ok1hra/IP-rotator/README.md

# IP-rotator firmware

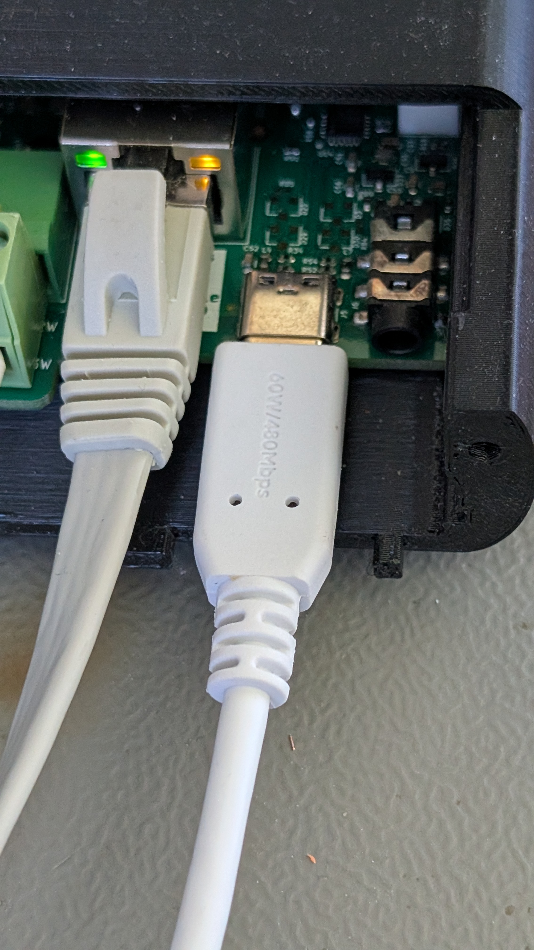
[picture p1: img/wiki-simple-rot-plug-usb-c.jpg]
https://raw.githubusercontent.com/ok1hra/IP-rotator/main/img/wiki-simple-rot-plug-usb-c.jpg


- First plug USB-C between rotator and PC
- Then open the Firmware page and follow the instructions [https://ok1hra.github.io/IP-rotator/](https://ok1hra.github.io/IP-rotator/)
- Manual available on the [Wiki page](https://remoteqth.com/w/doku.php?id=simple_rotator_interface_v) | [copy on GitHub](Assembly-manual.md)
