ok1hra/IP-rotator/control-zoom0.png

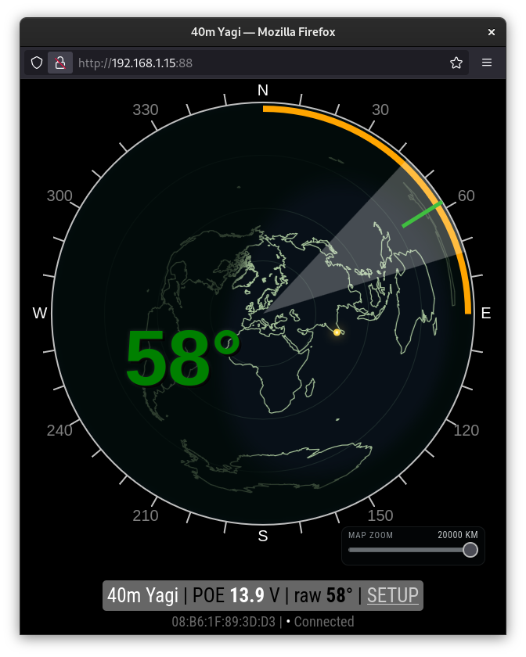
control-zoom0.png
