ok1hra/IP-rotator/control-zoom1.png

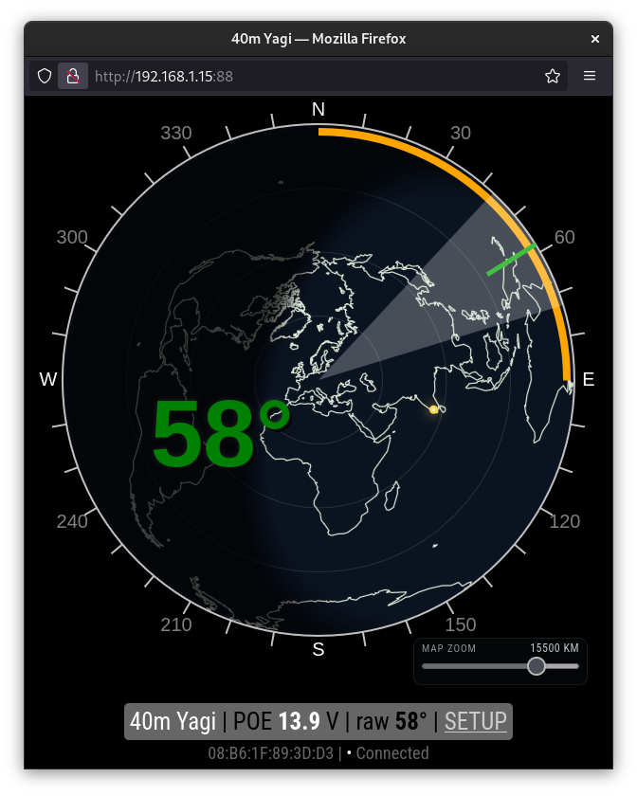
control-zoom1.png
