ok1hra/IP-rotator/control-zoom2.png

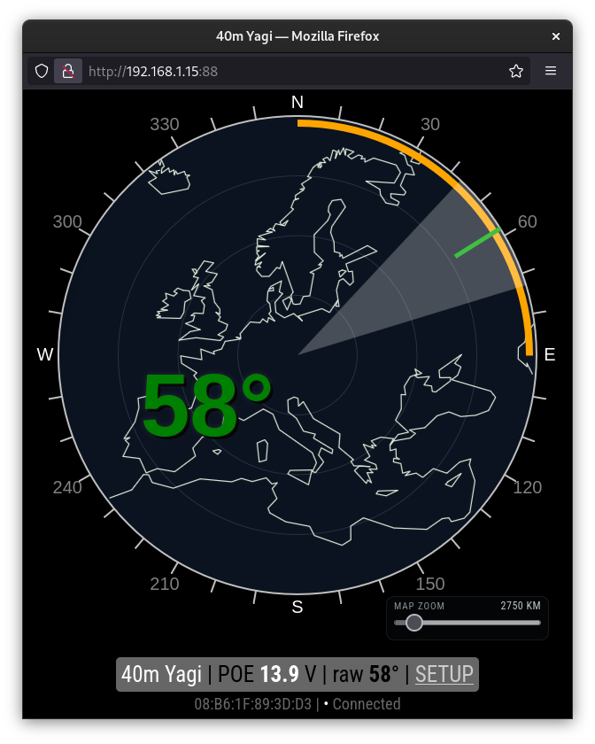
control-zoom2.png
