ok1hra/IP-rotator/elevation.png

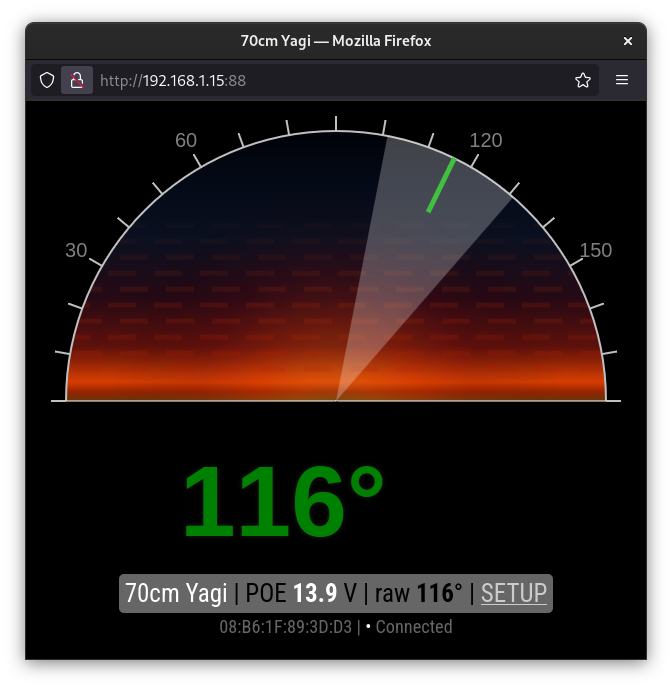
elevation.png
