ok1hra/IP-rotator/img/wiki-simple-rot-62.png

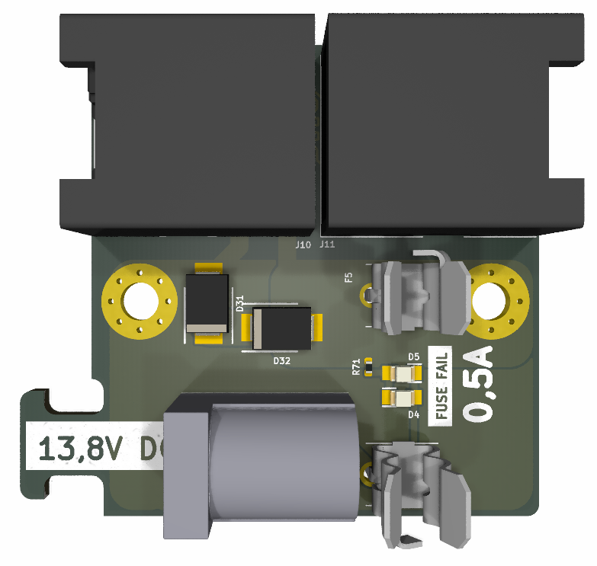
img/wiki-simple-rot-62.png
