ok1hra/IP-rotator/img/wiki-simple-rot-70.jpg

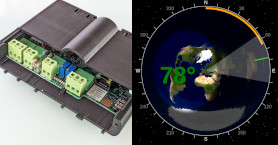
img/wiki-simple-rot-70.jpg
