ok1hra/IP-rotator/img/wiki-simple-rot-70b.jpg

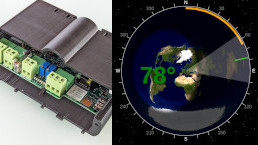
img/wiki-simple-rot-70b.jpg
