ok1hra/IP-rotator/img/wiki-simple-rot-render.png

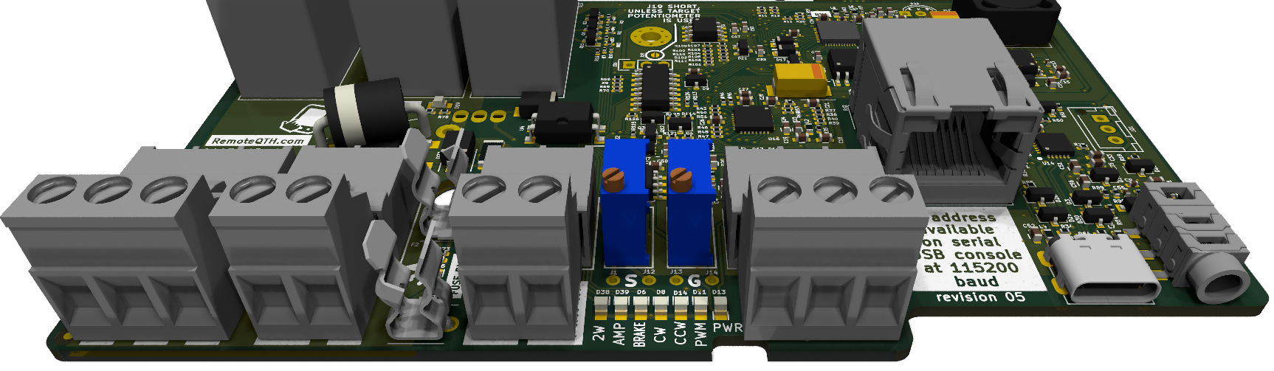
img/wiki-simple-rot-render.png
