ok1hra/IP-rotator/build/recovery-web/index.html

Two options - update or restore the entire device

# IP Rotator firmware

Firmware version: 20260912 for Hardware (https://remoteqth.com/w/doku.php?id=simple_rotator_interface_v)

## Update via the EasyOTA web service

Download the two .bin files and upload them on the device web update OTA page http://[ip]:82/update in this order: first firmware, then filesystem.

Files for EasyOTA update:

Firmware 20260912.bin SPIFFS 20260912.bin

## Complete recovery via USB

Use this path for device recovery. Open this page in Google Chrome or Microsoft Edge over https://, connect the IP Rotator to your computer using USB-C, then start the automated install below.

- Before recovery, back up your configuration from the Setup page http://[ip]:88/setup, Backup and restore part
- After pressing the Connect button, select the CP2104 USB to UART Bridge Controller device
- Then select the Install IP Rotator Recovery option
- After uploading, select the USB device again and the Logs & Console option, where after pressing Reset Device you will see the boot log, including the device's IP address

The installer flashes bootloader, partition table, boot_app0, firmware, and spiffs automatically.
