ok1hra/IP-rotator/setup.png

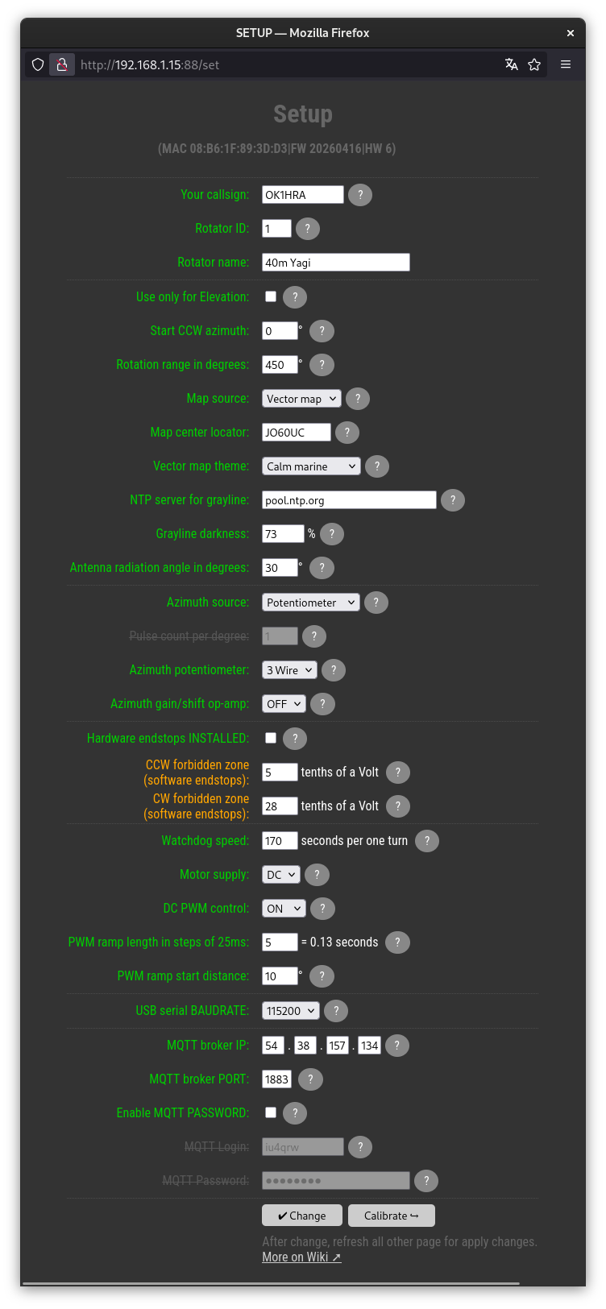
setup.png
