ok1hra/IP-rotator/calibrate.png

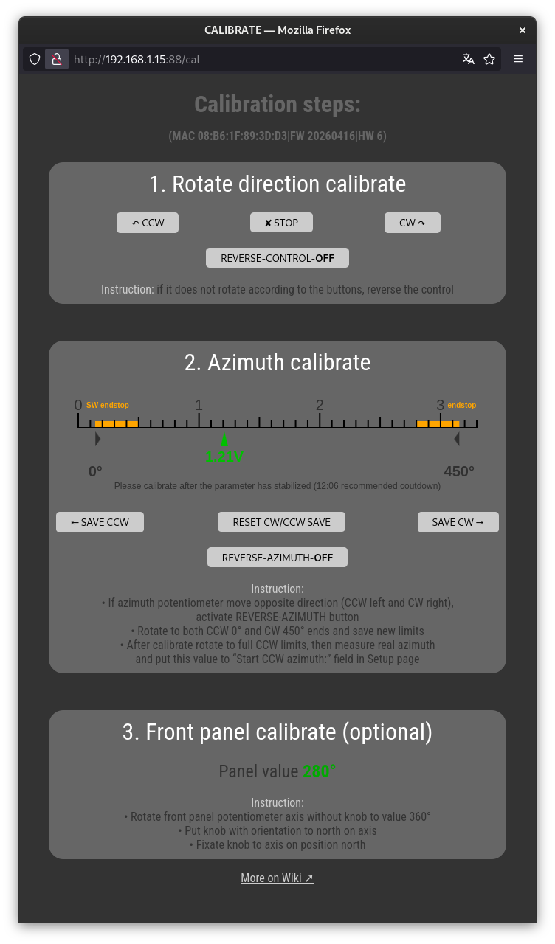
calibrate.png
