ok1hra/IP-rotator/(threads)

Thread 2 (2024-01-31):

Are you planning other positioning sensor in the future?

iu3qez, 2024-01-31:
Hi,

Happy user of the IP Interface. Really a great product.
Unfortunately my rotor had decided to give up: as usual the 500 ohm potentiometer is gone (I already tried to repair it.. But after a couple of weeks it broke again).

As this is a weak point of this kind of rotor (Hy Gain, CDE etc), I'm thinking to replace the 500 ohm potentiometer with some other positioning system...  Also their cost has gone crazy lately.

What I have in my mind are:
1) a simple magnetic encoder;
2) a magnetometer
3) some other kind of potentiometer based position.

I know that the hardware and software well support the 3), what about the other 2? Would be possible to implement without drastic change in the code?

73 de Simone IU3QEZ

ok1hra, 2024-02-04:
There are two options

1. use the analog input, i.e. if the sensor produces a voltage of 0-9V, you can connect it directly to the IP rotator
2. create an independent sensor that is connected to WiFi or Ethernet and sends location data via IP - it would require intervention in the code.

73, Dan OK1HRA

Closed 2024-04-29.

Thread 3 (2024-10-06):

PWM issue ?

jrueschenschmidt, 2024-10-06:
Hello Dan,

I think I found a bug in line 1889. I assume it should be -3.

1886   case -2: {
1887   	if(PWMenable==true){
1888    	    if(abs(AzimuthTarget-Azimuth)<10){
1889        	**Status=3**;
1890            }
1891        }else{
1892    	    if(abs(AzimuthTarget-Azimuth)<2){
1893		Status=-3;
1894	    }
1895       }

73 de Joerg (DL3QQ)

ok1hra, 2024-10-09:
Yes Joerg, it is bug.
Now fix in last release 20241009
TNX!

ok1hra, 2024-10-09:
close

Closed 2024-10-09.
