ok1hra/IP-rotator/IP-rotator.ino

/*

IP rotator firmware
----------------------
1. Increase REV value in this .ino
2. Arduino IDE 1.8.19 menu: Sketch/Export compiled Binary (for HARDWARE ESP32-POE + Tools/Partition Scheme:"Default")
3. optional if change: $ python3 tools/generate_map_dataset.py
4. generate all .bin and publish to GitHub web page: $ ./tools/all.sh --publish
5. git commit with comment Release number and push

For partial update witout release
1. Arduino IDE 1.8.19 menu: Sketch/Export compiled Binary (for HARDWARE ESP32-POE + Tools/Partition Scheme:"Default")
2. build SPIFFS.bin: $ tools/build_spiffs_image.sh
3. update va EasyOTA
4. git commit and push


 ___               _        ___ _____ _  _
| _ \___ _ __  ___| |_ ___ / _ \_   _| || |  __ ___ _ __
|   / -_) '  \/ _ \  _/ -_) (_) || | | __ |_/ _/ _ \ '  \
|_|_\___|_|_|_\___/\__\___|\__\_\|_| |_||_(_)__\___/_|_|_|

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
Used MQTT-WALL, credit Adam Hořčica, is under MIT license,
see https://github.com/bastlirna/mqtt-wall/blob/master/license.txt

Contributors: Joerg DL3QQ, Mark G4MEM

MQTT monitor
mosquitto_sub -v -h 192.168.1.200 -t 'OK1HRA/ROT/#'
mosquitto_sub -v -h 54.38.157.134 -t 'OK1HRA/1/ROT/#'

MQTT topic
mosquitto_pub -h 192.168.1.200 -t OK1HRA/0/ROT/Target -m '10'
mosquitto_pub -h 54.38.157.134 -t BD:2F/0/ROT/Target -m '10'
mosquitto_pub -h 54.38.157.134 -t 3D:D3/0/ROT/RxAzimuth -m '10'


Changelog:
+ rotator name
+ watchdog timer, azimuth change
+ stop zone gray color
+ under 11V POE voltage watchdog
+ azimuth target
+ rotator ID for more units mqtt identification
+ calibrate gui set
+ software endstop zone
+ darkzone map, if range < 360
+ watchdog speed limit in gui
+ HW detection show in GUI
+ web online status (timeout 2s)
+ on hover button
+ fix url button
+ diffrent low/high endstop zone
+ control key
+ AC functionality
+ AZ potentiometer
+ LED
+ Supported GS-232 commands: R L A S C Mxxx O F
+ CW/CCW pulse inputs gui
+ serial baudrate set
+ warm up timer for stable value
+ AZtwoWire L=three H=two wire AZ pot
+ AZpreamp L=preamp on H=pre amp off
+ if source AZsource == false && TwoWire == true && CwRaw < 1577 | then show recomended
+ add reverse azimuth button
+ click to map during rotate stoped
+ BRAKE in DC mode support
+ if mqtt_server_ip[0]=0 then disable MQTT
+ Disable PWM from setup gui
+ if PWM in gui OFF, AC-cw out for DC input, if PWM disable and high voltage
+ small stop ramp if(abs(AzimuthTarget-Azimuth)<2)
+ rename PWR to POE on main control page
+ reset button for calibrate settings in setup
+ calibrate control potentiometer on north (show ° in setup gui)
+ DC use brake relay
+ add AzimuthStop mqttpub
+ support HW rev 6 and 7
+ add new settings to setup gui for PWM
  - PWM ramp length
  - PWM start distance
+ add new azimuth source from MQTT with topic /RxAzimuth
+ add new parameter MQTT Login and Password
+ add support for Elevation only

ToDo
- test
  - if stop, after run over target
  + 10 turn pot without preamp
  + test preamp linearity
- save settings (dump eeprom?)
- show target from az pot in map
- disable target in map if status = 0 (not rotate)
- need implement
  - CW/CCW pulse functionality
  - CW/CCW pulse pulse per grad
  - serial protocol easycomm2
- watchdog if eth_connected = false; > 5s, then reconect
- do debugu vypisovat prumer casu behu hlavni smycky v ms
- vycistit kod
  https://stackoverflow.com/questions/3420975/html5-canvas-zooming
  https://codepen.io/chengarda/pen/wRxoyB

IDE 1.8.19
Použití knihovny WiFi ve verzi 2.0.0 v adresáři: /home/dan/Arduino/hardware/espressif/esp32/libraries/WiFi
Použití knihovny EEPROM ve verzi 2.0.0 v adresáři: /home/dan/Arduino/hardware/espressif/esp32/libraries/EEPROM
Použití knihovny WebServer ve verzi 2.0.0 v adresáři: /home/dan/Arduino/hardware/espressif/esp32/libraries/WebServer
Použití knihovny Ethernet ve verzi 2.0.0 v adresáři: /home/dan/Arduino/hardware/espressif/esp32/libraries/Ethernet
Použití knihovny ESPmDNS ve verzi 2.0.0 v adresáři: /home/dan/Arduino/hardware/espressif/esp32/libraries/ESPmDNS
Použití knihovny ArduinoOTA ve verzi 2.0.0 v adresáři: /home/dan/Arduino/hardware/espressif/esp32/libraries/ArduinoOTA
Použití knihovny Update ve verzi 2.0.0 v adresáři: /home/dan/Arduino/hardware/espressif/esp32/libraries/Update
Použití knihovny AsyncTCP ve verzi 1.1.1 v adresáři: /home/dan/Arduino/libraries/AsyncTCP
Použití knihovny ESPAsyncWebServer ve verzi 1.2.3 v adresáři: /home/dan/Arduino/libraries/ESPAsyncWebServer
Použití knihovny FS ve verzi 2.0.0 v adresáři: /home/dan/Arduino/hardware/espressif/esp32/libraries/FS
Použití knihovny AsyncElegantOTA ve verzi 2.2.7 v adresáři: /home/dan/Arduino/libraries/AsyncElegantOTA
Použití knihovny PubSubClient ve verzi 2.8 v adresáři: /home/dan/Arduino/libraries/PubSubClient
Použití knihovny Wire ve verzi 2.0.0 v adresáři: /home/dan/Arduino/hardware/espressif/esp32/libraries/Wire

*/
//-------------------------------------------------------------------------------------------------------
const char* REV = "20260913";
const char* FS_BUILD_INFO_PATH = "/fs_build.txt";

// #define CN3A                      // fix ip
float NoEndstopHighZone = 0;
float NoEndstopLowZone = 0;
bool Reverse = false;
bool ReverseAZ = false;
short CcwRaw = 0;
short CwRaw = 0;
short HardwareRev = 99;
unsigned int OneTurnLimitSec = 0;

// set from GUI
String YOUR_CALL = "";
String NET_ID = "";
String RotName = "";
int StartAzimuth = 0;         // max CCW limit callibrate in real using
unsigned int MaxRotateDegree = 0;
unsigned int AntRadiationAngle = 10;
String MapUrl = "" ;
byte MapSource = 1;          // 0 = URL bitmap, 1 = locator-based map
String MapLocator = "JO60UC";
unsigned int MapZoomKm = 20000;
String GraylineNtpServer = "pool.ntp.org";
byte GraylineDarkness = 80;
byte MapTheme = 1;
bool DefaultDegOverlayEnabled = true;
bool DefaultAntOverlayEnabled = true;
bool DefaultMapLocGridEnabled = false;
bool DefaultMapGraylineEnabled = true;
bool DefaultMapBordersEnabled = false;
bool DefaultMapDxccEnabled = false;
bool DefaultMapDxcSpotsEnabled = false;
bool DefaultMapDxcLinesEnabled = false;
bool FsMounted = false;
bool FsBuildInfoPresent = false;
bool FsBuildMatchesFirmware = false;
size_t FsTotalBytes = 0;
size_t FsUsedBytes = 0;
String FsBuildRev = "";
String FsBuildOffset = "";
String FsBuildSize = "";
                //$ /usr/bin/xplanet -window -config ./geoconfig -longitude 13.8 -latitude 50.0 -geometry 600x600 -projection azimuthal -num_times 1 -output ./map.png
                //$ /usr/bin/xplanet -window -config ./geoconfig -longitude 13.8 -latitude 50.0 -geometry 600x600 -projection azimuthal -radius 500 -num_times 1 -output ./OK500.png
bool Endstop =  false;
bool ACmotor =  false;
byte AZsource = 0;
short PulsePerDegree = 0;
bool AZtwoWire =  false;
bool AZpreamp =  false;

bool PWMenable = true;
unsigned int PwmRampSteps = 100;
unsigned int PwmUpDelay  = 3;  // [ms]*255steps
unsigned int PwmDwnDelay = 2;  // [ms]*255steps
byte dutyCycle = 0;
byte PwmMaxDuty = 255;
float AzimuthRawDeg = 0.0;
float AzimuthControlDeg = 0.0;
bool AzimuthControlInit = false;
float AzimuthNoiseDeg = 0.2;
float PwmSlowWindowDeg = 12.0;
byte PwmTuneAggressiveness = 2;
bool SkipBrakeLearningOnManualStop = false;
long PwmTuneSaveTimer = 0;
long StatusWatchdogTimer = 0;
long RotateWatchdogTimer = 0;
int AzimuthWatchdog = 0;
bool ErrorDetect = 0;
long TxMqttAzimuthTimer = 0;

//---------------------------------------------------------
// #define HWREV 8                     // PCB version [7-8]
#define OTAWEB                      // enable upload firmware via web
#define ETHERNET                    // Enable ESP32 ethernet (DHCP IPv4)
#define ETH_ADDR 0
#define ETH_TYPE ETH_PHY_LAN8720
#define ETH_POWER 0 //12                // #define ETH_PHY_POWER 0 ./Arduino/hardware/espressif/esp32/variants/esp32-poe/pins_arduino.h
#define ETH_MDC 23                  // MDC pin17
#define ETH_MDIO 18                 // MDIO pin16
#define ETH_CLK ETH_CLOCK_GPIO17_OUT    // CLKIN pin5 | settings for ESP32 GATEWAY rev f-g
String MACString;
char MACchar[18];
// #define ETH_CLK ETH_CLOCK_GPIO0_OUT    // settings for ESP32 GATEWAY rev c and older
// ETH.begin(ETH_ADDR, ETH_POWER, ETH_MDC, ETH_MDIO, ETH_TYPE, ETH_CLK);
// #define WIFI                     // Enable ESP32 WIFI (DHCP IPv4) - NOT TESTED
//-------------------------------------------------------------------------------------------------------

#include "driver/pcnt.h"
#include "esp_adc_cal.h"
const int AzimuthPin    = 39;  // analog
float AzimuthValue      = 0.0;
int Azimuth             = 0;
int AzimuthTarget       = -1;
int UiTargetAzimuth     = -1;
int RxAzimuth           = 0;
int Status              = 0; // -23 ManualPwmDwnCCW|-22 ManualCCW|-21 ManualStartCCW|-3 PwmDwnCCW|-2 CCW|-1 StartCCW|0 off|1 StartCW|2 CW|3 PwmDwnCW|21 ManualStartCW|22 ManualCW|23 ManualPwmDwnCW
const int VoltagePin    = 35;  // analog
float VoltageValue      = 0.0;
const float VoltageLimit = 11.5; // Keep in sync with the client-side undervoltage warning shown in data/index.html.
const int ReversePin    = 16;  //
const int PwmPin        = 4;   //

const int HWidPin       = 34;  // analog
int HWidValue           = 0;
// HardwareRev 1
const int ACcwPin       = 2;
const int BrakePin      = 33;
// const int CwCcwButtPin  = 36;  // analog
const int CwInputPin    = 36;
const int CcwInputPin   = 5;
int CwCcwInputValue      = 0;
const pcnt_unit_t CwPulseCounterUnit = PCNT_UNIT_0;
const pcnt_unit_t CcwPulseCounterUnit = PCNT_UNIT_1;
long PulseCounterValue = 0;
unsigned int PulseAzimuthTenths = 0;
bool PulseCounterConfigured = false;
const int AZmasterPin   = 32;  // analog
int AZmaster            = 142;
int AZmasterValue       = 0;
const int LedRPin       = 15;
const int LedGPin       = 14;
const int LedBPin       = 0;
const int AZtwoWirePin  = 13;
const int AZpreampPin   = 12;

// setting PWM properties
const int PwmFreq = 1000;
const int PwmResolution = 8;
const int mosfetPWMChannel = 0;
const int greenPWMChannel = 2;

// unsigned long TimerTemp;

// interrupts
#include "esp_attr.h"

// values
char WebAuthPasswordBuffer[101];
long MeasureTimer[2]={2800000,300000};   //  millis,timer (5 min)

/*
1mm rain = 15,7cm^2/10 = 1,57ml     <- by rain funnel radius
10ml = 11,5 pulses = 0,87ml/pulse   <- constanta tilting measuring cup
*/

long AlertTimer[2]={0,60000};
//  |alert...........|alert........... everry max 1 minutes and with publish max value in period

// 73 seconds WDT (WatchDogTimer)
#include <esp_task_wdt.h>
#define WDT_TIMEOUT 73
long WdtTimer=0;

byte InputByte[21];
// #define Ser2net                  // Serial to ip proxy - DISABLE if board revision 0.3 or lower
int EnableSerialDebug     = 0;
long FreneticModeTimer ;
#define HTTP_SERVER_PORT  80     // Web server port
#define DEFAULT_SWITCH_UDP_PORT 88
#define ShiftOut                 // Enable ShiftOut register
#define UdpAnswer                // Send UDP answer confirm packet

int BaudRate = 115200; // serial debug baudrate
int incomingByte = 0;   // for incoming serial data

int i = 0;
#include <WiFi.h>
#include <WiFiUdp.h>
#include <MD5Builder.h>
#include "EEPROM.h"
#define EEPROM_SIZE 756   /*

 0|Byte    1|128
 1|Char    1|A
 2|UChar   1|255
 3|Short   2|-32768
 5|UShort  2|65535
 7|Int     4|-2147483648
11|Uint    4|4294967295
15|Long    4|-2147483648
19|Ulong   4|4294967295
23|Long64  8|0x00FFFF8000FF4180
31|Ulong64 8|0x00FFFF8000FF4180
39|Float   4|1234.1234
43|Double  8|123456789.12345679
51|Bool    1|1

0-1   - NET_ID
2-22  - RotName
23  - StartAzimuth UShort
25  - MaxRotateDegree UShort
27  - AntRadiationAngle UShort
29  - Endstop Bool
30  - ACmotor Bool
31-32 - CcwRaw
33-34 - CwRaw
35 - Reverse
36 - NoEndstopLowZone
37-40 - reserved legacy
41-140 - Web authentication password
141-160 - YOUR_CALL
161-164 - MQTT broker IP
165-166 - MQTT_PORT
167 - ELEVATION
168 - MQTT_LOGIN
169-219 - MapUrl
220-221 - OneTurnLimitSec
222 - NoEndstopHighZone
223 - AZsource
224-225 PulsePerDegree
226-227 BaudRate
228 AZtwoWire
229 AZpreamp
230 - ReverseAZ
231 - PWMenable
232 - WebAuthEnabled
233 - WebAuth password storage format marker
234-5 PwmRampSteps UShort
236-245 - MQTT_USER
246-265 - MQTT_PASS
266 - MapSource (0 URL, 1 Locator)
267-272 - MapLocator (6 chars Maidenhead)
273-274 - MapZoomKm (1000-20000)
275-324 - GraylineNtpServer
325 - GraylineDarkness (0-100)
326 - MapTheme (0-5)
327 - PwmMaxDuty (40-255)
328-329 - PwmSlowWindowDeg x10 UShort
330 - PwmTuneAggressiveness (0-4)
331-394 - DXC host/IP
395-396 - DXC port
397-412 - DXC callsign
413 - DefaultDegOverlayEnabled
414 - DefaultAntOverlayEnabled
415 - DefaultMapLocGridEnabled
416 - DefaultMapGraylineEnabled
417 - DefaultMapBordersEnabled
418 - DefaultMapDxccEnabled
419 - DefaultMapDxcSpotsEnabled
420-421 - PulseAzimuthTenths UShort
422-485 - DXC MQTT publish topic (left mouse button)
486 - DefaultMapDxcLinesEnabled
487-550 - DXC MQTT publish topic (middle mouse button)
551-614 - DXC MQTT publish topic (right mouse button)
615-616 - TrxNetPort UShort
617 - TrxNetSubEnabled Bool
618-689 - TrxNetPrio (space-separated priority prefixes, max 8 x 8 chars)
690 - TrxNetPrioInit (0x01 = user has set TrxNetPrio; else load default "INK 705")
691 - DxcWifiltEnabled Bool (gates the map only; WIFILT pushes spots to /setDxcSpots)
692-755 - free (was WIFILT DXC host, dropped when the map stopped dialling out)

!! Increment EEPROM_SIZE #define !!

*/
#define CONFIG_BACKUP_FORMAT "ip-rotator-config"
#define CONFIG_BACKUP_VERSION 1
int Altitude = 0;
unsigned long WatchdogTimer=0;
String ConfigBackupUploadBuffer = "";
String ConfigBackupUploadError = "";
bool WebAuthEnabled = false;
#include <mbedtls/sha1.h>

//ajax
#include <WebServer.h>
#include "SPIFFS.h"
WebServer ajaxserver(HTTP_SERVER_PORT+8);
const char* WEB_AUTH_USER = "admin";
const char* WEB_AUTH_REALM = "IP rotator";
const char* WEB_AUTH_HEADERS[] = {"Authorization"};
String WebDigestNonce = "";
String WebDigestOpaque = "";
String WebAuthPassword = "";
WiFiClient DxcTelnetClient;
WiFiClient DxcWsClient;
String DxcHost = "";
uint16_t DxcPort = 7300;
String DxcCallsign = "";
String DxcMqttTopic = "";
String DxcMqttTopicMiddle = "";
String DxcMqttTopicRight = "";
const char* DEFAULT_DXC_HOST = "ve7cc.net";
const uint16_t DEFAULT_DXC_PORT = 23;
bool DxcWifiltEnabled = false;
// Spot mailbox. WIFILT's browser page POSTs a snapshot of the spots it is showing
// to /setDxcSpots; the map reads it back same-origin. Nothing here ever dials out,
// and the whole thing is RAM only - a power cycle simply starts empty.
#define DXC_SPOT_MAX_SPOTS 120
#define DXC_SPOT_MAX_BODY 8192
#define DXC_SPOT_MAX_AGE_MS 600000UL
String g_dxcSpotsJson = "";      // the "spots" array exactly as posted, capped
bool g_dxcSpotTelnet = false;    // WIFILT's own cluster login state, from the blob
uint32_t g_dxcSpotAtMs = 0;      // millis() of the last accepted POST; 0 = never
bool DxcTelnetStatus = false;
bool DxcWsStatus = false;
bool DxcTelnetLoginPending = false;
unsigned long DxcReconnectTimer = 0;

WiFiServer server(HTTP_SERVER_PORT);
#if defined(CN3A)
  bool DHCP_ENABLE = 0;
#else
  bool DHCP_ENABLE = 1;
#endif
// Client variables
char linebuf[80];
int charcount=0;
//The udp library class
WiFiUDP UdpCommand;
uint8_t buffer[50] = "";
unsigned char packetBuffer[10];
int UDPpacketSize;
#include <ETH.h>
static bool eth_connected = false;
#include <TrxNet.h>
WiFiUDP  trxUdp;
TrxNet   net(trxUdp);
bool     trxNetStarted     = false;
int      trxLastPublishedAz = -999;
uint32_t trxLastPublishMs   = 0;
volatile int32_t  trxPendingAz  = -1;
volatile int32_t  trxPendingEl  = -1;
volatile bool     trxAzPending  = false;
volatile bool     trxElPending  = false;
volatile bool     trxGreetPending = false;   // a peer joined/rebooted — send it a snapshot from loop()
char              trxGreetName[33] = {0};     // name of the peer to greet (filled in the callback)
uint16_t TrxNetPort        = 5683;
bool     TrxNetSubEnabled  = false;
// Priority prefixes (TrxNet peer-eviction protection). Max 8 prefixes x 8 chars,
// space-separated. TrxNetPrio holds the editable raw string; the parse buffer and
// pointer array below are handed to net.setPriorityPrefixes() and MUST stay valid
// for the lifetime of the net object (library requirement), so they are global.
#define TRXNET_PRIO_MAX_PREFIXES 8
#define TRXNET_PRIO_MAX_LEN      8
String   TrxNetPrio        = "INK 705";
char     TrxNetPrioBuf[72]  = {0};                       // tokenized: spaces -> '\0'
const char* TrxNetPrioPtrs[TRXNET_PRIO_MAX_PREFIXES] = {0};
uint8_t  TrxNetPrioCount   = 0;
String HTTP_req;
#if defined(OTAWEB)
  #include <AsyncTCP.h>
  #include <ESPAsyncWebServer.h>
  #include "src/AsyncElegantOTA_IPR/AsyncElegantOTA_IPR.h"
  AsyncWebServer OTAserver(82);
#endif

#define MQTT               // Enable MQTT debug
#if defined(MQTT)
  #include <PubSubClient.h>
  // #include "PubSubClient.h" // lokalni verze s upravou #define MQTT_MAX_PACKET_SIZE 128
  // WiFiClient esp32Client;
  // PubSubClient mqttClient(esp32Client);
  WiFiClient espClient;
  PubSubClient mqttClient(espClient);
  // PubSubClient mqttClient(ethClient);
   // PubSubClient mqttClient(server, 1883, callback, ethClient);
   long lastMqttReconnectAttempt = 0;
#endif
boolean MQTT_ENABLE     = 1;          // enable public to MQTT broker
IPAddress mqtt_server_ip(0, 0, 0, 0);
// byte BrokerIpArray[2][4]{
//   // {192,168,1,200},   // MQTT broker remoteqth.com
//   {54,38,157,134},   // MQTT broker remoteqth.com
// };
// IPAddress server(10, 24, 213, 92);    // MQTT broker
int MQTT_PORT;       // MQTT broker PORT
// int MQTT_PORT_Array[2] = {
//   1883,
//   1883
// };       // MQTT broker PORT
boolean ELEVATION      = 0;          // enable Elevation function
boolean MQTT_LOGIN      = 0;          // enable MQTT broker login
String MQTT_USER= "";    // MQTT broker user login
String MQTT_PASS= "";   // MQTT broker password

const int MqttBuferSize = 1000; // 1000
char mqttTX[MqttBuferSize];
char mqttPath[MqttBuferSize];
// char mqttTX[100];
// char mqttPath[100];
long MqttStatusTimer[2]{1500,1000};
long HeartBeatTimer[2]={0,1000};

// Shift register
// CC1 12 CLOCK
// CC2 13 DATA
// SBU1 14 LATCH
// SBU2 15
// const int ShiftOutClockPin = 12;
// const int ShiftOutDataPin = 13;
// const int ShiftOutLatchPin = 14;
// byte ShiftOutByte=0x00;

bool rxShiftInRead;
// https://randomnerdtutorials.com/esp32-i2c-communication-arduino-ide/
#include <Wire.h>
#define I2C_SDA 33
#define I2C_SCL 32

// const int EnablePin = 13;
// const int ButtonPin = 34;

#if defined(Ser2net)
  #define RX1 3
  #define TX1 1
  HardwareSerial Serial_one(1);
#endif

// SD
// #define ETH_CLK_MODE ETH_CLOCK_GPIO17_OUT
// #define ETH_PHY_POWER 12
// #include "FS.h"
// #include "SD_MMC.h"

// ntp
#include "time.h"
// const char* ntpServer = "tik.cesnet.cz";
// const char* ntpServer = "time.google.com";
const long  gmtOffset_sec = 0;
const int   daylightOffset_sec = 0;

void ApplyGraylineNtpConfig(){
  configTime(gmtOffset_sec, daylightOffset_sec, GraylineNtpServer.c_str());
}

bool GraylineUtcAvailable(time_t* nowOut = nullptr){
  time_t now = time(nullptr);
  if(now < 1700000000){
    return false;
  }
  if(nowOut != nullptr){
    *nowOut = now;
  }
  return true;
}

// Explicit prototypes keep Arduino's sketch preprocessor from breaking
// if the large comment header is malformed or contains unusual content.
uint32_t readADC_Cal(int ADC_Raw);
bool IsSafeWebAuthPasswordValue(const String& value);
bool IsSafeMqttPublishTopicValue(const String& value);
bool LooksLikeLegacyWebAuthKey(const String& value);
void Watchdog();
void LedStatus();
void LedStatusErr();
void RotCalculate();
void RunTimer();
void DetectEndstopZone();
void EthTest();
void RunByStatus();
void ReverseProcedure(bool CCW);
String LeadingZero(int NumberOfZero, int NR);
void CLI2();
void Enter();
void EnterChar(int OUT);
void Prn(int OUT, int LN, String STR);
void ListCommands(int OUT);
String ReadSerialCommandTail(byte maxLen, unsigned long timeoutMs);
void PrintWebKey(int OUT);
void DisableWebAuth(int OUT);
void http();
void EthEvent(WiFiEvent_t event);
void Mqtt();
bool mqttReconnect();
void reSubscribe();
void MqttRx(char *topic, byte *payload, unsigned int length);
void AfterMQTTconnect();
bool MqttPublishRawTopic(const String& topic, const String& data, bool retain);
void MqttPubString(String TOPIC, String DATA, bool RETAIN);
String UtcTime(int format);
void InitWebAuth();
String Md5Hex(const String& value);
String DigestRandomHex();
String ExtractHttpHeader(const String& request, const String& headerName);
String ExtractDigestParam(const String& authHeader, const String& name, char delimiter);
bool CheckDigestAuthorization(const String& authHeader, const String& method, const String& uri);
void SendHttpDigestChallenge(WiFiClient& webClient);
bool RequireAjaxAuth();
bool AjaxAuthOk();
void RegisterAjaxRoute(const char* uri, WebServer::THandlerFunction handler);
void RegisterAjaxRoute(const char* uri, HTTPMethod method, WebServer::THandlerFunction handler);
void handleTrxNetPeers();
void RegisterAjaxUploadRoute(const char* uri, HTTPMethod method, WebServer::THandlerFunction handler, WebServer::THandlerFunction uploadHandler);
void handlePostRot();
void handleSet();
void handleCal();
bool loadTextFile(const char* path, String& contents);
bool streamStaticFile(const char* path, const char* contentType);
void handleApp();
void handleRoot();
void handleADC();
void handleAZ();
void handleFrontAZ();
void handleAZadc();
void handleAZsource();
void handlePulseCounter();
void handleStat();
void handleTargetUi();
void handleStart();
void handleElevation();
void handleMax();
void handleAnt();
void handleAntName();
void handleMapUrl();
void handleMapSource();
void handleMapLocator();
void handleMapZoomKm();
void handleReadDxcMqttTopic();
void handleReadDxcMqttTopics();
void handleReadDxcSource();
void handleSetDxcSpots();
void DxcHandleRawSpotPost(WiFiClient& webClient, const String& request, const String& uri);
int DxcStoreSpotBlob(const String& body);
bool DxcSpotKeyOk(const String& key);
void handleReadDxcSpots();
bool DxcSpotsExtractArray(const String& body, String& outArray);
void handleSetMapLocator();
void handleSetMapZoomKm();
void handleMapTheme();
void handleGraylineDarkness();
void handleMapDisplayDefaults();
void handleGraylineInfo();
void handleRev();
void handleFsDiag();
void handlePwmUi();
void handleSetPwmMaxDuty();
void handleMap50js();
void handleMap50jsGz();
void handleFontRegular();
void handleFontBold();
void handleMqttWallJs();
void handleMqttWallCss();
void handleBackupConfigDownload();
void handleBackupConfigUpload();
void handleBackupConfigUploadData();
void handleEndstop();
void handleEndstopLowZone();
void handleEndstopHighZone();
void handleSetEndstopZones();
void handleCwraw();
void handleCcwraw();
void handleMAC();
void handleUptime();
void handleDxcHtml();
void handleDxcPublishFreq();
int NormalizeCompassAzimuth(int azimuth);
int InternalToCompassAzimuth(int internalAzimuth);
int CompassToInternalAzimuth(int compassAzimuth);
int CompassAzimuthDelta(int a, int b);
void onSetAzimuth(const char* from, const uint8_t* data, size_t len);
void onSetElevation(const char* from, const uint8_t* data, size_t len);
void trxNetBegin();
void trxNetPublish();
void trxNetProcessPending();
void DxcLoop();
void DxcDisconnectTelnet();
void DxcDisconnectWebSocket();
bool DxcConfigReady();
void DxcRequestReconnect();
bool DxcConnectTelnet();
void DxcUpdateTelnetStatus(bool connected, bool forceSend = false);
void DxcSendTelnetStatus();
bool DxcHandleWebSocketUpgrade(WiFiClient& webClient, const String& request, const String& method, const String& uri);
String DxcComputeWebSocketAccept(const String& secKey);
String Base64Encode(const uint8_t* data, size_t length);
bool DxcSendWebSocketFrame(uint8_t opcode, const uint8_t* payload, size_t length);
bool DxcSendWebSocketText(const char* text);
bool DxcSendWebSocketText(const String& text);
void DxcHandleWebSocketClient();
void DxcHandleTelnetClient();
void WriteFixedStringToEeprom(int start, int length, const String& text);
float ClampFloat(float value, float minValue, float maxValue);
byte ClampDuty(int value);
float ReadControlAzimuthDeg();
float ReadRawAzimuthDeg();
float ReadRemainingDistanceDeg(int directionSign, float azimuthDeg);
float GetStopToleranceDeg();
bool TargetReachedInDirection(int directionSign);
byte ComputeClosedLoopDuty(int directionSign);
void ApplyDutySlew(byte targetDuty, long &PwmTimer);
void MaybeBeginBrakeLearning(int directionSign, bool &brakeLearningActive, int &brakeLearningDirection, float &brakeStartDistance);
void UpdateAutoSlowWindow(float brakeStartDistance, float finalDistance);
void PersistAutoSlowWindowIfNeeded();
void RefreshFilesystemDiagnostics();
bool LoadFilesystemBuildInfo();
float GetPwmTuneAggressionFactor();
String JsonEscape(const String& value);
bool IsSafeConfigChar(byte value);
String NormalizeTrxNetPrio(const String& in, bool* valid);
void ParseTrxNetPrio();
String ReadFixedStringFromEeprom(int start, int length);
bool JsonExtractString(const String& json, const char* key, String& value);
bool JsonExtractLong(const String& json, const char* key, long& value);
bool JsonExtractFloat(const String& json, const char* key, float& value);
bool JsonExtractBool(const String& json, const char* key, bool& value);
String ExportConfigBackupJson();
String ImportConfigBackupJson(const String& jsonPayload);
float GetPwmTuneLeadOffsetDeg();
bool ShouldForceStopFromPwmStall(int directionSign, byte currentDuty, float rawAzimuthDeg, byte maxDuty);
void RequestStopRamp(bool suppressBrakeLearning);
bool IsManualStatusValue(int statusValue);
bool IsManualPwmKeyControlEnabled();
void RequestManualStopRamp();
bool HandleManualPwmStatus(long &PwmTimer);
bool IsPulseAzimuthSource();
void ConfigurePulseCounter();
void ApplyAzimuthSourceMode(bool useStoredPulseAzimuth);
void UpdatePulseAzimuthFromCounter();
void PersistPulseAzimuthIfNeeded(bool forceSave);
unsigned int ClampPulseAzimuthTenths(int valueTenths);
long ClampPulseCount(long pulseCount);
int GetPulseVirtualAdcValue();
int GetPulseCounterValue();

//-------------------------------------------------------------------------------------------------------

void setup() {

  pinMode(AzimuthPin, INPUT);
  // pinMode(CwCcwButtPin, INPUT);
  pinMode(CwInputPin, INPUT);
  pinMode(CcwInputPin, INPUT);
  ConfigurePulseCounter();

  pinMode(HWidPin, INPUT);
    HWidValue = readADC_Cal(analogRead(HWidPin));
    if(HWidValue<=150){
      HardwareRev=0;
    }else if(HWidValue>150 && HWidValue<=450){
      HardwareRev=3;  // 319
    }else if(HWidValue>450 && HWidValue<=700){
      HardwareRev=4;  // 604
    }else if(HWidValue>700 && HWidValue<=900){
      HardwareRev=5;  // 807
    }else if(HWidValue>900 && HWidValue<=1170){
      HardwareRev=6;  // 1036
    }else if(HWidValue>1170){
      HardwareRev=7;  // 1304
    }
  pinMode(VoltagePin, INPUT);
  pinMode(ReversePin, OUTPUT);
    digitalWrite(ReversePin, LOW);


  ledcSetup(mosfetPWMChannel, PwmFreq, PwmResolution);
  ledcSetup(greenPWMChannel, PwmFreq, PwmResolution);
  ledcAttachPin(PwmPin, mosfetPWMChannel);
  ledcAttachPin(LedGPin, greenPWMChannel);
  ledcWrite(mosfetPWMChannel, 0);
  ledcWrite(greenPWMChannel, 0);

  // HardwareRev 1
  pinMode(AZmasterPin, INPUT);
  pinMode(ACcwPin, OUTPUT);
    digitalWrite(ACcwPin, LOW);
  pinMode(BrakePin, OUTPUT);
    digitalWrite(BrakePin, LOW);
  pinMode(LedRPin, OUTPUT);
    digitalWrite(LedRPin, LOW);
  // pinMode(LedGPin, OUTPUT);
  //   digitalWrite(LedGPin, HIGH);
  pinMode(LedBPin, OUTPUT);
    digitalWrite(LedBPin, LOW);

  pinMode(AZtwoWirePin, OUTPUT);
    digitalWrite(AZtwoWirePin, LOW);
  pinMode(AZpreampPin, OUTPUT);
    digitalWrite(AZpreampPin, LOW);

  // pinMode(ShiftOutClockPin, OUTPUT);
  // pinMode(ShiftOutDataPin, OUTPUT);
  // pinMode(ShiftOutLatchPin, OUTPUT);
  // digitalWrite(ShiftOutLatchPin, HIGH);

  // for (int i = 0; i < 8; i++) {
  //   pinMode(TestPin[i], INPUT);
  // }
  // pinMode(EnablePin, OUTPUT);
  // digitalWrite(EnablePin,1);

  // pinMode(ButtonPin, INPUT);
  // SHIFT IN
  // pinMode(ShiftInLatchPin, OUTPUT);
  // pinMode(ShiftInClockPin, OUTPUT);
  // pinMode(ShiftInDataPin, INPUT);

    // Listen source
  if (!EEPROM.begin(EEPROM_SIZE)){
    // if(EnableSerialDebug>0){
    //   Serial.println("failed to initialise EEPROM"); delay(1);
    // }
  }

  // 226-227 BaudRate
  if(EEPROM.read(226)==0xff || EEPROM.readUShort(226) > 9600){
    BaudRate=115200;
  }else{
    BaudRate = EEPROM.readUShort(226);
  }

  Serial.begin(BaudRate); //BaudRate
  while(!Serial) {
    ; // wait for serial port to connect. Needed for native USB port only
  }

  // // SD
  // if(!SD_MMC.begin()){
  //   Serial.println("SD card Mount Failed");
  //   // return;
  // }


  // 0-1 net ID
    if(EEPROM.read(0)==0xff){
      NET_ID="";
    }else{
      NET_ID = ReadFixedStringFromEeprom(0, 2);
    }

  // 2-22 RotName
  if(EEPROM.read(2)==0xff){
    RotName="Antenna";
  }else{
    RotName = ReadFixedStringFromEeprom(2, 21);
  }

  // 23 StartAzimuth
  if(EEPROM.read(23)==0xff){
    StartAzimuth=0;
  }else{
    if(EEPROM.readUShort(23)<359 && EEPROM.readUShort(23)>0){
      StartAzimuth = EEPROM.readUShort(23);
    }
  }

  // 25 MaxRotateDegree
  if(EEPROM.read(25)==0xff){
    MaxRotateDegree=360;
  }else{
    MaxRotateDegree = EEPROM.readUShort(25);
  }

  // 27 AntRadiationAngle
  if(EEPROM.read(27)==0xff){
    AntRadiationAngle=45;
  }else{
    if(EEPROM.readUShort(27)<180 && EEPROM.readUShort(27)>0){
      AntRadiationAngle = EEPROM.readUShort(27);
    }else{
      AntRadiationAngle=46;
    }
  }

  // 169-219 - MapUrl
  if(EEPROM.read(169)==0xff){
    MapUrl="https://remoteqth.com/xplanet/OK.png";
  }else{
    MapUrl = ReadFixedStringFromEeprom(169, 51);
  }

  // 266 - MapSource
  if(EEPROM.read(266)==0xff){
    MapSource=1;
  }else{
    if(EEPROM.readByte(266)<2){
      MapSource = EEPROM.readByte(266);
    }else{
      MapSource=1;
    }
  }

  // 267-272 - MapLocator
  if(EEPROM.read(267)==0xff){
    MapLocator="JO60UC";
  }else{
    MapLocator = ReadFixedStringFromEeprom(267, 6);
    MapLocator.toUpperCase();
    if(MapLocator.length()!=6){
      MapLocator="JO60UC";
    }
  }

  // 273-274 - MapZoomKm
  if(EEPROM.read(273)==0xff){
    MapZoomKm=20000;
  }else{
    if(EEPROM.readUShort(273)>=1000 && EEPROM.readUShort(273)<=20000){
      MapZoomKm = EEPROM.readUShort(273);
    }else{
      MapZoomKm=20000;
    }
  }

  // 275-324 - GraylineNtpServer
  if(EEPROM.read(275)==0xff){
    GraylineNtpServer = "pool.ntp.org";
  }else{
    GraylineNtpServer = ReadFixedStringFromEeprom(275, 50);
    GraylineNtpServer.trim();
    if(GraylineNtpServer.length()<1 || GraylineNtpServer.length()>50){
      GraylineNtpServer = "pool.ntp.org";
    }
  }

  // 325 - GraylineDarkness
  if(EEPROM.read(325)==0xff){
    GraylineDarkness = 80;
  }else{
    if(EEPROM.readByte(325) <= 100){
      GraylineDarkness = EEPROM.readByte(325);
    }else{
      GraylineDarkness = 80;
    }
  }

  // 326 - MapTheme
  if(EEPROM.read(326)==0xff){
    MapTheme = 1;
  }else{
    if(EEPROM.readByte(326) <= 5){
      MapTheme = EEPROM.readByte(326);
    }else{
      MapTheme = 1;
    }
  }

  // 413-419 and 486 - control page default map/display toggles
  if(EEPROM.read(413)==0xff){
    DefaultDegOverlayEnabled = true;
  }else{
    DefaultDegOverlayEnabled = EEPROM.readBool(413);
  }
  if(EEPROM.read(414)==0xff){
    DefaultAntOverlayEnabled = true;
  }else{
    DefaultAntOverlayEnabled = EEPROM.readBool(414);
  }
  if(EEPROM.read(415)==0xff){
    DefaultMapLocGridEnabled = false;
  }else{
    DefaultMapLocGridEnabled = EEPROM.readBool(415);
  }
  if(EEPROM.read(416)==0xff){
    DefaultMapGraylineEnabled = true;
  }else{
    DefaultMapGraylineEnabled = EEPROM.readBool(416);
  }
  if(EEPROM.read(417)==0xff){
    DefaultMapBordersEnabled = false;
  }else{
    DefaultMapBordersEnabled = EEPROM.readBool(417);
  }
  if(EEPROM.read(418)==0xff){
    DefaultMapDxccEnabled = false;
  }else{
    DefaultMapDxccEnabled = EEPROM.readBool(418);
  }
  if(EEPROM.read(419)==0xff){
    DefaultMapDxcSpotsEnabled = false;
  }else{
    DefaultMapDxcSpotsEnabled = EEPROM.readBool(419);
  }
  if(EEPROM.read(420)==0xff){
    PulseAzimuthTenths = 0;
  }else{
    PulseAzimuthTenths = ClampPulseAzimuthTenths(EEPROM.readUShort(420));
  }
  if(EEPROM.read(486)==0xff){
    DefaultMapDxcLinesEnabled = false;
  }else{
    DefaultMapDxcLinesEnabled = EEPROM.readBool(486);
  }

  // 29  - Endstop
  if(EEPROM.read(29)==0xff){
    Endstop=false;
  }else{
    if(EEPROM.readBool(29)==1){
      Endstop=true;
    }else{
      Endstop=false;
    }
  }

  // 30  - ACmotor
  if(EEPROM.read(30)==0xff){
    ACmotor=false;
  }else{
    if(EEPROM.readBool(30)==1){
      ACmotor=true;
    }else{
      ACmotor=false;
    }
  }

  // 31-32 CcwRawBaudRate
  if(EEPROM.read(31)==0xff){
    CcwRaw=392;
  }else{
    CcwRaw = EEPROM.readUShort(31);
  }

  // 33-34  CwRaw
  if(EEPROM.read(33)==0xff){
    CwRaw=3000;
  }else{
    CwRaw = EEPROM.readUShort(33);
  }

  // 35 - Reverse
  if(EEPROM.read(35)==0xff){
    Reverse=false;
  }else{
    if(EEPROM.readBool(35)==1){
      Reverse=true;
    }else{
      Reverse=false;
    }
  }

  // 36 - NoEndstopLowZone
  if(EEPROM.read(36)==0xff){
    NoEndstopLowZone = 0.5;
  }else{
    if(EEPROM.readByte(36)<16){
      NoEndstopLowZone = float(EEPROM.readByte(36))/10;
    }else{
      NoEndstopLowZone = 0.5;
    }
  }


  // 167  - ELEVATION
  if(EEPROM.read(167)==0xff){
    ELEVATION=false;
  }else{
    if(EEPROM.readBool(167)==1){
      ELEVATION=true;
    }else{
      ELEVATION=false;
    }
  }

  // 168  - MQTT_LOGIN
  if(EEPROM.read(168)==0xff){
    MQTT_LOGIN=false;
  }else{
    if(EEPROM.readBool(168)==1){
      MQTT_LOGIN=true;
    }else{
      MQTT_LOGIN=false;
    }
  }

  // 222 - NoEndstopHighZone
  if(EEPROM.read(222)==0xff){
    NoEndstopHighZone = 2.8;
  }else{
    if(EEPROM.readByte(222)>15 && EEPROM.readByte(222)<34){
      NoEndstopHighZone = float(EEPROM.readByte(222))/10;
    }else{
      NoEndstopHighZone = 2.8;
    }
  }
  // NoEndstopHighZone = 3.3 - NoEndstopLowZone;
  // NoEndstopLowZone = NoEndstopLowZone;

  // 223 - AZsource
  if(EEPROM.read(223)==0xff){
    AZsource=0;
  }else{
    AZsource=EEPROM.readByte(223);
  }

  // 224-225  PulsePerDegree
  if(EEPROM.read(224)==0xff){
    PulsePerDegree=1;
  }else{
    PulsePerDegree = EEPROM.readUShort(224);
  }

  // 228 AZtwoWire
  if(EEPROM.read(228)==0xff){
    AZtwoWire=false;
  }else{
    if(EEPROM.readBool(228)==1){
      AZtwoWire=true;
    }else{
      AZtwoWire=false;
    }
  }
  digitalWrite(AZtwoWirePin, AZtwoWire);

  // 229 AZpreamp
  if(EEPROM.read(229)==0xff){
    AZpreamp=false;
  }else{
    if(EEPROM.readBool(229)==1){
      AZpreamp=true;
    }else{
      AZpreamp=false;
    }
  }
  digitalWrite(AZpreampPin, AZpreamp);

  // 230 - ReverseAZ
  if(EEPROM.read(230)==0xff){
    ReverseAZ=false;
  }else{
    if(EEPROM.readBool(230)==1){
      ReverseAZ=true;
    }else{
      ReverseAZ=false;
    }
  }

  // 231 - PWMenable = true;
  if(EEPROM.read(231)==0xff){
    PWMenable=false;
  }else{
    if(EEPROM.readBool(231)==1){
      PWMenable=true;
    }else{
      PWMenable=false;
    }
  }

  // 234 PwmRampSteps UShort
  if(EEPROM.read(234)==0xff){
    PwmRampSteps=100;
  }else{
    PwmRampSteps = EEPROM.readUShort(234);
    if(PwmRampSteps<1 || PwmRampSteps>200){
      PwmRampSteps=100;
    }
  }

  // 327 PwmMaxDuty
  if(EEPROM.read(327)==0xff){
    PwmMaxDuty=255;
  }else{
    PwmMaxDuty = EEPROM.readByte(327);
    if(PwmMaxDuty<40){
      PwmMaxDuty=40;
    }
  }

  // 328-329 PwmSlowWindowDeg x10
  if(EEPROM.read(328)==0xff){
    PwmSlowWindowDeg=12.0;
  }else{
    PwmSlowWindowDeg = float(EEPROM.readUShort(328)) / 10.0;
    if(PwmSlowWindowDeg < 3.0 || PwmSlowWindowDeg > 60.0){
      PwmSlowWindowDeg=12.0;
    }
  }

  // 330 PwmTuneAggressiveness
  if(EEPROM.read(330)==0xff){
    PwmTuneAggressiveness=2;
  }else{
    PwmTuneAggressiveness = EEPROM.readByte(330);
    if(PwmTuneAggressiveness > 4){
      PwmTuneAggressiveness=2;
    }
  }

  // 331-394 DXC host/IP
  if(EEPROM.read(331)==0xff){
    DxcHost = "";
  }else{
    DxcHost = ReadFixedStringFromEeprom(331, 64);
  }

  // 395-396 DXC port
  if(EEPROM.read(395)==0xff){
    DxcPort = 7300;
  }else{
    DxcPort = EEPROM.readUShort(395);
    if(DxcPort < 1){
      DxcPort = 7300;
    }
  }

  // 397-412 DXC callsign
  if(EEPROM.read(397)==0xff){
    DxcCallsign = YOUR_CALL;
  }else{
    DxcCallsign = ReadFixedStringFromEeprom(397, 16);
  }

  // 422-485 DXC MQTT publish topic
  if(EEPROM.read(422)==0xff){
    DxcMqttTopic = "";
  }else{
    DxcMqttTopic = ReadFixedStringFromEeprom(422, 64);
    DxcMqttTopic.trim();
    if(!IsSafeMqttPublishTopicValue(DxcMqttTopic)){
      DxcMqttTopic = "";
    }
  }

  // 487-550 DXC MQTT publish topic (middle mouse button)
  if(EEPROM.read(487)==0xff){
    DxcMqttTopicMiddle = "";
  }else{
    DxcMqttTopicMiddle = ReadFixedStringFromEeprom(487, 64);
    DxcMqttTopicMiddle.trim();
    if(!IsSafeMqttPublishTopicValue(DxcMqttTopicMiddle)){
      DxcMqttTopicMiddle = "";
    }
  }

  // 551-614 DXC MQTT publish topic (right mouse button)
  if(EEPROM.read(551)==0xff){
    DxcMqttTopicRight = "";
  }else{
    DxcMqttTopicRight = ReadFixedStringFromEeprom(551, 64);
    DxcMqttTopicRight.trim();
    if(!IsSafeMqttPublishTopicValue(DxcMqttTopicRight)){
      DxcMqttTopicRight = "";
    }
  }

  // 691 DxcWifiltEnabled
  if(EEPROM.read(691)==0xff){
    DxcWifiltEnabled = false;
  }else{
    DxcWifiltEnabled = EEPROM.readBool(691);
  }

  // 615-616 TrxNetPort
  if(EEPROM.read(615)==0xff){
    TrxNetPort = 5683;
  }else{
    TrxNetPort = EEPROM.readUShort(615);
    if(TrxNetPort == 0) TrxNetPort = 5683;
  }

  // 617 TrxNetSubEnabled
  if(EEPROM.read(617)==0xff){
    TrxNetSubEnabled = false;
  }else{
    TrxNetSubEnabled = EEPROM.readBool(617);
  }

  // 618-689 TrxNetPrio, 690 init flag. Factory-fresh EEPROM (flag not set) loads
  // the default "INK 705"; once the user has saved (flag == 0x01), an empty stored
  // value stays empty (feature off) instead of reverting to the default.
  if(EEPROM.read(690) != 0x01){
    TrxNetPrio = "INK 705";
  }else{
    TrxNetPrio = ReadFixedStringFromEeprom(618, 72);
  }

  // 236-245 - MQTT_USER
  if(EEPROM.read(236)==0xff){
    MQTT_USER="Login";
  }else{
    MQTT_USER = ReadFixedStringFromEeprom(236, 10);
  }

  // 246-265 - MQTT_PASS
  if(EEPROM.read(246)==0xff){
    MQTT_PASS="Password";
  }else{
    MQTT_PASS = ReadFixedStringFromEeprom(246, 20);
  }

  // 41-140 WebAuthPassword
  for(int i=41; i<141; i++){
    char currentChar = EEPROM.readChar(i);
    if(currentChar == char(0xff) || currentChar == '\0'){
      WebAuthPasswordBuffer[i-41] = '\0';
      break;
    }
    WebAuthPasswordBuffer[i-41] = currentChar;
  }
  WebAuthPasswordBuffer[100] = '\0';
  WebAuthPassword = String(WebAuthPasswordBuffer);
  bool webAuthPasswordStoredDirectly = EEPROM.readByte(233) == 0xA5;
  if(!webAuthPasswordStoredDirectly && LooksLikeLegacyWebAuthKey(WebAuthPassword)){
    WebAuthPassword = Md5Hex(WebAuthPassword);
    WriteFixedStringToEeprom(41, 100, WebAuthPassword);
    EEPROM.writeByte(233, 0xA5);
    EEPROM.commit();
  }else if(!webAuthPasswordStoredDirectly){
    EEPROM.writeByte(233, 0xA5);
    EEPROM.commit();
  }

  // 232 - WebAuthEnabled, default OFF on blank EEPROM.
  if(EEPROM.read(232)==0xff){
    WebAuthEnabled = false;
  }else{
    WebAuthEnabled = EEPROM.readBool(232);
  }
  InitWebAuth();
  ApplyAzimuthSourceMode(true);

  // YOUR_CALL
  // move after ETH init

  // MQTT broker IP
  if(EEPROM.read(161)==0xff){
    mqtt_server_ip[0]=54;
  }else{
    mqtt_server_ip[0]=EEPROM.readByte(161);
    if(mqtt_server_ip[0]==0){
      MQTT_ENABLE = false;
    }
  }

  if(EEPROM.read(162)==0xff){
    mqtt_server_ip[1]=38;
  }else{
    mqtt_server_ip[1]=EEPROM.readByte(162);
  }

  if(EEPROM.read(163)==0xff){
    mqtt_server_ip[2]=157;
  }else{
    mqtt_server_ip[2]=EEPROM.readByte(163);
  }

  if(EEPROM.read(164)==0xff){
    mqtt_server_ip[3]=134;
  }else{
    mqtt_server_ip[3]=EEPROM.readByte(164);
  }

  if(EEPROM.read(165)==0xff){
    MQTT_PORT=1883;
  }else{
    MQTT_PORT = EEPROM.readUShort(165);
  }

  // OneTurnLimitSec
  if(EEPROM.read(220)==0xff){
    OneTurnLimitSec=360;
  }else{
    OneTurnLimitSec = EEPROM.readUShort(220);
  }
  // // 231-234 Altitude
  // if(EEPROM.readByte(231)!=255){
  //   Altitude = EEPROM.readInt(231);
  // }

  #if defined(ETHERNET)
    // mqtt_server_ip=BrokerIpArray[0];
    // MQTT_PORT = MQTT_PORT_Array[0];

    WiFi.onEvent(EthEvent);
    // ETH.begin();
    ETH.begin(ETH_ADDR, ETH_POWER, ETH_MDC, ETH_MDIO, ETH_TYPE, ETH_CLK);
    if(DHCP_ENABLE==false){
      ETH.config(IPAddress(192, 168, 0, 11), IPAddress(192, 168, 0, 1),IPAddress(255, 255, 255, 0),IPAddress(8, 8, 8, 8));
      //config(IPAddress local_ip, IPAddress gateway, IPAddress subnet, IPAddress dns1 = (uint32_t)0x00000000, IPAddress dns2 = (uint32_t)0x00000000);
    }
  #endif
    RefreshFilesystemDiagnostics();
    server.begin();
    UdpCommand.begin(DEFAULT_SWITCH_UDP_PORT);    // incoming udp port
    // chipid=ESP.getEfuseMac();//The chip ID is essentially its MAC address(length: 6 bytes).
    //   unsigned long long1 = (unsigned long)((chipid & 0xFFFF0000) >> 16 );
    //   unsigned long long2 = (unsigned long)((chipid & 0x0000FFFF));
    //   ChipidHex = String(long1, HEX) + String(long2, HEX); // six octets
    //   YOUR_CALL=ChipidHex;

  #if defined(OTAWEB)
    OTAserver.on("/", HTTP_GET, [](AsyncWebServerRequest *request) {
        if(WebAuthEnabled && !request->authenticate(WEB_AUTH_USER, WebAuthPassword.c_str())){
          return request->requestAuthentication();
        }
        request->send(200, "text/plain", "PSE QSY to /update");
    });
    AsyncElegantOTA_IPR.begin(&OTAserver, WEB_AUTH_USER, WebAuthPassword.c_str(), &WebAuthEnabled, REV);    // Start OTA
    OTAserver.begin();
  #endif
  //------------------------------------------------

  // digitalWrite(EnablePin,0);

  // WDT
  esp_task_wdt_init(WDT_TIMEOUT, true); //enable panic so ESP32 restarts
  esp_task_wdt_add(NULL); //add current thread to WDT watch
  WdtTimer=millis();

  // init and get UTC for grayline and other time-dependent features
   ApplyGraylineNtpConfig();

   // ajax
   ajaxserver.collectHeaders(WEB_AUTH_HEADERS, 1);
   RegisterAjaxRoute("/", HTTP_POST, handlePostRot);
   // ajaxserver.on("/STOP",HTTP_POST, handlePostStop);
   RegisterAjaxRoute("/", handleRoot);      //This is display page
   RegisterAjaxRoute("/app", handleApp);
   RegisterAjaxRoute("/setup", handleSet);
   RegisterAjaxRoute("/readADC", handleADC);//To get update of ADC Value only
  RegisterAjaxRoute("/readAZ", handleAZ);
  RegisterAjaxRoute("/readFrontAZ", handleFrontAZ);
  RegisterAjaxRoute("/readAZadc", handleAZadc);
  RegisterAjaxRoute("/readAZsource", handleAZsource);
  RegisterAjaxRoute("/readPulseCounter", handlePulseCounter);
  RegisterAjaxRoute("/readStat", handleStat);
   RegisterAjaxRoute("/readTargetUi", handleTargetUi);
   RegisterAjaxRoute("/readStart", handleStart);
   RegisterAjaxRoute("/readElevation", handleElevation);
   RegisterAjaxRoute("/readMax", handleMax);
   RegisterAjaxRoute("/readAnt", handleAnt);
   RegisterAjaxRoute("/readAntName", handleAntName);
   RegisterAjaxRoute("/readMapUrl", handleMapUrl);
   RegisterAjaxRoute("/readMapSource", handleMapSource);
   RegisterAjaxRoute("/readMapLocator", handleMapLocator);
   RegisterAjaxRoute("/readMapZoomKm", handleMapZoomKm);
   RegisterAjaxRoute("/readDxcMqttTopic", handleReadDxcMqttTopic);
   RegisterAjaxRoute("/readDxcMqttTopics", handleReadDxcMqttTopics);
   RegisterAjaxRoute("/readDxcSource", handleReadDxcSource);
   RegisterAjaxRoute("/readDxcSpots", HTTP_GET, handleReadDxcSpots);
   ajaxserver.on("/setDxcSpots", HTTP_POST, handleSetDxcSpots);   // no digest gate on purpose, see handler
   RegisterAjaxRoute("/setMapLocator", handleSetMapLocator);
  RegisterAjaxRoute("/setMapZoomKm", handleSetMapZoomKm);
  RegisterAjaxRoute("/readMapTheme", handleMapTheme);
  RegisterAjaxRoute("/readMapDisplayDefaults", handleMapDisplayDefaults);
  RegisterAjaxRoute("/readGraylineDarkness", handleGraylineDarkness);
  RegisterAjaxRoute("/readGraylineInfo", handleGraylineInfo);
  RegisterAjaxRoute("/readRev", handleRev);
 RegisterAjaxRoute("/readFsDiag", handleFsDiag);
 RegisterAjaxRoute("/readPwmUi", handlePwmUi);
 RegisterAjaxRoute("/setPwmMaxDuty", handleSetPwmMaxDuty);
 RegisterAjaxRoute("/backup/config", HTTP_GET, handleBackupConfigDownload);
 RegisterAjaxUploadRoute("/backup/config", HTTP_POST, handleBackupConfigUpload, handleBackupConfigUploadData);
 RegisterAjaxRoute("/map50.js", handleMap50js);
  RegisterAjaxRoute("/map50.js.gz", handleMap50jsGz);
  RegisterAjaxRoute("/RC-R.ttf", handleFontRegular);
  RegisterAjaxRoute("/RC-B.ttf", handleFontBold);
  RegisterAjaxRoute("/mqtt-wall.js", handleMqttWallJs);
  RegisterAjaxRoute("/mqtt-wall.css", handleMqttWallCss);
  RegisterAjaxRoute("/dxc.html", handleDxcHtml);
  RegisterAjaxRoute("/dxcPublishFreq", HTTP_POST, handleDxcPublishFreq);
  RegisterAjaxRoute("/set", handleSet);
  RegisterAjaxRoute("/cal", handleCal);
  RegisterAjaxRoute("/readEndstop", handleEndstop);
  RegisterAjaxRoute("/readEndstopLowZone", handleEndstopLowZone);
  RegisterAjaxRoute("/readEndstopHighZone", handleEndstopHighZone);
  RegisterAjaxRoute("/setEndstopZones", handleSetEndstopZones);
  RegisterAjaxRoute("/readCwraw", handleCwraw);
  RegisterAjaxRoute("/readCcwraw", handleCcwraw);
  RegisterAjaxRoute("/readMAC", handleMAC);
  RegisterAjaxRoute("/readUptime", handleUptime);
  RegisterAjaxRoute("/trxnet/peers", handleTrxNetPeers);
   // ajaxserver.on("/cal/readAZ", handleAZ);
   ajaxserver.begin();                  //Start server
   Serial.println("HTTP ajax server started");

}

//-------------------------------------------------------------------------------------------------------

void loop() {
  http();
  Mqtt();
  CLI2();
  ajaxserver.handleClient();
  DxcLoop();
  RunByStatus();
  Watchdog();
  if (NET_ID.length() > 0) {
    net.loop();
    trxNetPublish();
    trxNetProcessPending();
    trxNetGreet();
  }

  #if defined(OTAWEB)
   // OTAserver.on("/printIp", HTTP_GET, [](AsyncWebServerRequest *request){
   //     request->send(200, "text/plain", "ok");
   //     Serial.println(request->client()->remoteIP());
   // });
   AsyncElegantOTA_IPR.loop();
  #endif


  // shift register test
  // for (int i=0; i<8; i++){
  //   bitSet(ShiftOutByte, i);
  //   ShiftOutSet(ShiftOutByte);
  //   bitClear(ShiftOutByte, i);
  //   delay(100);
  // }

}
// SUBROUTINES -------------------------------------------------------------------------------------------------------

// void ShiftOutSet(byte SetByte){
//   digitalWrite(ShiftOutLatchPin, LOW);
//   shiftOut(ShiftOutDataPin, ShiftOutClockPin, LSBFIRST, SetByte);
//   digitalWrite(ShiftOutLatchPin, HIGH);
// }

//-------------------------------------------------------------------------------------------------------
uint32_t readADC_Cal(int ADC_Raw)
{
  esp_adc_cal_characteristics_t adc_chars;

  esp_adc_cal_characterize(ADC_UNIT_1, ADC_ATTEN_DB_11, ADC_WIDTH_BIT_12, 1100, &adc_chars);
  return(esp_adc_cal_raw_to_voltage(ADC_Raw, &adc_chars));
}
//-------------------------------------------------------------------------------------------------------
void Watchdog(){
  static long ADCTimer = 0;
  static long ADCCounter = 0;
  static int AZBuffer = 0;
  static int AZmasterBuffer = 0;
  static float VoltageBuffer = 0;
  // Azimuth refresh 175 ms
  if(millis()-ADCTimer > 5){
    AZBuffer = AZBuffer + readADC_Cal(analogRead(AzimuthPin));
    AZmasterBuffer = AZmasterBuffer + readADC_Cal(analogRead(AZmasterPin));
    // R divider | 12,95/2,95=4,38983050847458
    VoltageBuffer = VoltageBuffer + readADC_Cal(analogRead(VoltagePin))/1000.0*4.39;
    ADCCounter ++;
    if(ADCCounter > 34){
      AzimuthValue = AZBuffer/35;
      AZmasterValue = AZmasterBuffer/35;
      VoltageValue = VoltageBuffer/35;
      ADCCounter = 0;
      AZBuffer = 0;
      AZmasterBuffer = 0;
      VoltageBuffer = 0;
      CwCcwInputValue = 0;
      if(digitalRead(CwInputPin)==LOW){
        CwCcwInputValue = 1;
      }
      if(digitalRead(CcwInputPin)==LOW){
        CwCcwInputValue = 2;
      }

      if(ReverseAZ==true){
        AzimuthValue=map(AzimuthValue, 142, 3155, 3155, 142);
      }
    }
    if(AZsource == 0){ //potentiometer
      AzimuthRawDeg=map(AzimuthValue, CcwRaw, CwRaw, 0, MaxRotateDegree);
      float controlAlpha = (Status==0) ? 0.18 : 0.45;
      if(AzimuthControlInit==false){
        AzimuthControlDeg = AzimuthRawDeg;
        AzimuthControlInit = true;
      }else{
        AzimuthControlDeg = AzimuthControlDeg + (AzimuthRawDeg - AzimuthControlDeg) * controlAlpha;
      }
      AzimuthNoiseDeg = AzimuthNoiseDeg * 0.92 + abs(AzimuthRawDeg - AzimuthControlDeg) * 0.08;
      Azimuth=int(round(AzimuthRawDeg));
    }else if(IsPulseAzimuthSource()){
      UpdatePulseAzimuthFromCounter();
    }else{
      AzimuthRawDeg=Azimuth;
      AzimuthControlDeg=Azimuth;
      AzimuthNoiseDeg=0.2;
    }
    ADCTimer=millis();
    AZmaster=map(AZmasterValue, 142, 3150, 0, 360);
    if(AZmaster<=180){
      AZmaster=AZmaster+180;
    }else{
      AZmaster=AZmaster-180;
    }
  }

  // KEY
  if(AZsource==0){ // potentiometer
    static bool RunByKey = false;
    if(IsManualPwmKeyControlEnabled()){
      RunByKey=false;
      if(CwCcwInputValue==1){
        if(Status==0){
          Status=21;
        }
      }else if(CwCcwInputValue==2){
        if(Status==0){
          Status=-21;
        }
      }else if(IsManualStatusValue(Status)){
        RequestManualStopRamp();
      }
    }else if(CwCcwInputValue==1 && Status>=0){
      if(Status==0){
        Status=1; //digitalWrite(BrakePin, HIGH); delay(24);
        RunByKey=true;
      }
      // RunTimer();
    }else if(CwCcwInputValue==2 && Status<=0){
      if(Status==0){
        Status=-1; //digitalWrite(BrakePin, HIGH); delay(24);
        RunByKey=true;
      }
      // RunTimer();
    }else if(RunByKey==true){
      RequestStopRamp(true);
      RunByKey=false;
    }
  }

  static long AZchangeTimer = 0;
  static int AzimuthTmp = 0;
  static int CwCcwInputValueTmp = 0;
  static float VoltageValueTmp = 0;
  static int StatusTmp = 0; // -3 PwmDwnCCW|-2 CCW|-1 PwmUpCCW|0 off|1 PwmUpCW|2 CW|3 PwmDwnCW
  static String StatusStr = "";

  // Status change
  if(StatusTmp!=Status){
    switch (Status) {
      case -23: {StatusStr = "ManualPwmDwn-CCW"; break; }
      case -22: {StatusStr = "Manual-CCW"; break; }
      case -21: {StatusStr = "ManualStart-CCW"; break; }
      case -3: {StatusStr = "PwmDwn-CCW"; break; }
      case -2: {StatusStr = "CCW"; break; }
      case -11: {StatusStr = "PwmUp-CCW"; break; }
      case -1: {StatusStr = "START-CCW"; break; }
      case  0: {StatusStr = "STOP"; break; }
      case  1: {StatusStr = "START-CW"; break; }
      case  21: {StatusStr = "ManualStart-CW"; break; }
      case  22: {StatusStr = "Manual-CW"; break; }
      case  23: {StatusStr = "ManualPwmDwn-CW"; break; }
      case  11: {StatusStr = "PwmUp-CW"; break; }
      case  2: {StatusStr = "CW"; break; }
      case  3: {StatusStr = "PwmDwn-CW"; break; }
    }
    MqttPubString("StatusHuman", StatusStr, false);
    MqttPubString("Status", String(Status+0), false); // +4)
    if(Status == 0 && StatusTmp != 0){
      PersistPulseAzimuthIfNeeded(true);
    }
    StatusTmp=Status;
    LedStatus();
  }

  // info if change AZ and voltage
  if( (Status==0 && millis()-AZchangeTimer >2000) || (Status!=0 && millis()-AZchangeTimer >100) ){
    if(AzimuthTmp!=Azimuth){
      MqttPubString("Azimuth", String(Azimuth), false);
      if(Status==0){
        MqttPubString("AzimuthStop", String(Azimuth), false);
      }
      AzimuthTmp=Azimuth;
      TxMqttAzimuthTimer=millis();
    }
    if(CwCcwInputValueTmp!=CwCcwInputValue){
      MqttPubString("CwCcwInputValue", String(CwCcwInputValue), false);
      CwCcwInputValueTmp=CwCcwInputValue;
    }
    if(abs(VoltageValueTmp-VoltageValue)>0.5){
      MqttPubString("VoltageValue", String(VoltageValue), false);
      VoltageValueTmp=VoltageValue;
    }
    AZchangeTimer=millis();
  }

  // minimal Azimuth propagation (heartbeat) 1 min
  if(millis()-TxMqttAzimuthTimer > 60000){
    MqttPubString("Azimuth", String(Azimuth), false);
    if(Status==0){
      MqttPubString("AzimuthStop", String(Azimuth), false);
    }
    TxMqttAzimuthTimer=millis();
  }
  PersistPulseAzimuthIfNeeded(false);

  static long PwmTelemetryTimer = 0;
  static float PwmSlowWindowPrev = -1.0;
  static float StopTolerancePrev = -1.0;
  if(millis()-PwmTelemetryTimer > 5000){
    float stopToleranceDeg = GetStopToleranceDeg();
    if(abs(PwmSlowWindowPrev-PwmSlowWindowDeg) > 0.09 || PwmSlowWindowPrev < 0){
      MqttPubString("PwmSlowWindowDeg", String(PwmSlowWindowDeg, 1), false);
      PwmSlowWindowPrev = PwmSlowWindowDeg;
    }
    if(abs(StopTolerancePrev-stopToleranceDeg) > 0.04 || StopTolerancePrev < 0){
      MqttPubString("StopToleranceDeg", String(stopToleranceDeg, 2), false);
      StopTolerancePrev = stopToleranceDeg;
    }
    PwmTelemetryTimer=millis();
  }

  if(Status!=0){
    // status watchdog timeout
    if(millis()-StatusWatchdogTimer > 120000){ // after 90sec
      if(IsManualStatusValue(Status)){
        RequestManualStopRamp();
      }else if(Status<0){
        Status=-3;
      }else{
        Status=3;
      }
      ErrorDetect=1;
      MqttPubString("Debug", "Stopped by 120s timeout", false);
      StatusWatchdogTimer = StatusWatchdogTimer+5000; // next 5sec check
    }
    // Azimuth change watchdog
    if(millis()-RotateWatchdogTimer > 10000){    // check every 10 sec
      if(abs(AzimuthWatchdog-Azimuth)> 360/(OneTurnLimitSec/10) ){ // OneTurnLimitSec 90 = 360/90/10
        RotateWatchdogTimer=millis();
        AzimuthWatchdog=Azimuth;
      }else{
        if(IsManualStatusValue(Status)){
          RequestManualStopRamp();
        }else if(Status<0){
          Status=-3;
        }else{
          Status=3;
        }
        ErrorDetect=1;
        MqttPubString("Debug", "Stopped after not reaching "+String(360/(OneTurnLimitSec/10) )+"° change in 10s", false);
        RotateWatchdogTimer=millis();
      }
    }
  }

  //POE voltage check
  static long DCunderVoltageWatchdog = 0;
  if(millis()-DCunderVoltageWatchdog > 1000){
    if(Status==1 || Status==2 || Status==-1 || Status==-2 || Status==21 || Status==22 || Status==-21 || Status==-22){
        if(VoltageValue < VoltageLimit){
          if(IsManualStatusValue(Status)){
            RequestManualStopRamp();
          }else if(Status<0){
            Status=-3;
          }else{
            Status=3;
          }
          MqttPubString("Debug", "Stopped by under voltage 11,5V POE", false);
          ErrorDetect=1;
        }
    }
    DCunderVoltageWatchdog=millis();
  }

  // debug
  static long DebugTimer = 0;
  if(millis()-DebugTimer > 2000){
      // MqttPubString("AzimuthRAW", String(analogRead(AzimuthPin)), false);
      // MqttPubString("MaxRotateDegree", String(MaxRotateDegree), false);
      // MqttPubString("AzimuthRAWcal", String(AzimuthValue), false);
      // MqttPubString("MaxLimitDegree", String(MaxLimitDegree), false);
      // MqttPubString("AzimuthValue", String(AzimuthValue/1000.0), false);
      // MqttPubString("CwCcwInputValue", String(CwCcwInputValue/1000.0), false);
      // MqttPubString("HWidValue", String(HWidValue/1000.0), false);

      DebugTimer=millis();
  }

  // WDT
  if(millis()-WdtTimer > 60000){
    esp_task_wdt_reset();
    WdtTimer=millis();
    if(EnableSerialDebug>0){
      Prn(3, 0,"WDT reset ");
      Prn(3, 1, UtcTime(1));
    }
  }

  // AZ master potentiometer - must ne on end of Watchdog() because RunByStatus() must be next step
  // static int AZtargetTmp = 0;
  static bool Run = false;
  static long AZmasterChangeTimer = 0;
  static int AZmasterTmp = AZmaster;
  if(millis()<10000 || Status!=0){
    AZmasterTmp=AZmaster;
  }
  if( Status==0 && abs(AZmaster-AZmasterTmp)>3 && Run==false){
    AZmasterTmp=AZmaster;
    Run = true;
    UiTargetAzimuth = AZmaster;
    AZmasterChangeTimer=millis();
    // MqttPubString("AZmasterStart", String(AZmaster), false);
  }
  if( Status==0 && abs(AZmaster-AZmasterTmp)>3 && Run==true){
    AZmasterChangeTimer=millis();
    AZmasterTmp=AZmaster;
    UiTargetAzimuth = AZmaster;
    // MqttPubString("AZmasterRun", String(AZmaster), false);
  }
  if( Status==0 && millis()-AZmasterChangeTimer >2000 && abs(AZmaster-AZmasterTmp)<=3 && Run==true){
    AZmasterTmp=AZmaster;
    UiTargetAzimuth = AZmaster;
    AzimuthTarget = AZmaster - StartAzimuth;
    if(AzimuthTarget<0){
        AzimuthTarget = 360+AzimuthTarget;
    }
    RotCalculate();
    Run = false;
    MqttPubString("AzimuthTargetPot", String(AzimuthTarget), false);
    // MqttPubString("AZmasterStop", String(AZmaster), false);
  }
}

//-------------------------------------------------------------------------------------------------------

// LED
void LedStatus(){
  switch (Status) {
    case -23: {
      digitalWrite(LedRPin, HIGH);
      ledcWrite(greenPWMChannel, 0);
      break; }
    case -22: {
      digitalWrite(LedRPin, HIGH);
      ledcWrite(greenPWMChannel, 0);
      break; }
    case -21: {
      digitalWrite(LedRPin, HIGH);
      ledcWrite(greenPWMChannel, 0);
      break; }
    case -3: {
      digitalWrite(LedRPin, HIGH);
      ledcWrite(greenPWMChannel, 0);
      break; }
    case -2: {
      digitalWrite(LedRPin, HIGH);
      ledcWrite(greenPWMChannel, 0);
      break; }
    case -1: {
      digitalWrite(LedRPin, HIGH);
      ledcWrite(greenPWMChannel, 0);
      break; }
    case  0: {
      digitalWrite(LedRPin, LOW);
      digitalWrite(LedBPin, LOW);
      break; }
    case  1: {
      digitalWrite(LedRPin, HIGH);
      ledcWrite(greenPWMChannel, 0);
      break; }
    case  21: {
      digitalWrite(LedRPin, HIGH);
      ledcWrite(greenPWMChannel, 0);
      break; }
    case  22: {
      digitalWrite(LedRPin, HIGH);
      ledcWrite(greenPWMChannel, 0);
      break; }
    case  23: {
      digitalWrite(LedRPin, HIGH);
      ledcWrite(greenPWMChannel, 0);
      break; }
    case  2: {
      digitalWrite(LedRPin, HIGH);
      ledcWrite(greenPWMChannel, 0);
      break; }
    case  3: {
      digitalWrite(LedRPin, HIGH);
      ledcWrite(greenPWMChannel, 0);
      break; }
  }
}
//-------------------------------------------------------------------------------------------------------
void LedStatusErr(){
  static byte dutyCycleLed = 0;
  static bool dutyCycleLedDown = 0;
  if(ErrorDetect==1){
    if(dutyCycleLedDown==0){
      dutyCycleLed++;
      if(dutyCycleLed==255){
        dutyCycleLedDown=1;
      }
    }else{
      dutyCycleLed--;
      if(dutyCycleLed==0){
        dutyCycleLedDown=0;
      }
    }
    ledcWrite(greenPWMChannel, dutyCycleLed);
  }else{

    ledcWrite(greenPWMChannel, 255);
  }
}

//-------------------------------------------------------------------------------------------------------

void RotCalculate(){
  if(VoltageValue < VoltageLimit){
    AzimuthTarget=-1;
    UiTargetAzimuth=-1;
    MqttPubString("Debug", "Target ignore by under voltage 11,5V POE", false);
  }else{
    // overlap detect
    if(Azimuth < MaxRotateDegree/2 && AzimuthTarget < MaxRotateDegree/2){ // MaxRotateDegree/2 = HalfPoint
      //CCW
    }else{
      if(MaxRotateDegree>360 && AzimuthTarget<MaxRotateDegree-360){  // if in overlap
        AzimuthTarget=AzimuthTarget+360;      // go to overlap
      }
      //CW
    }

    // direction
    if(AzimuthTarget>=0 && AzimuthTarget <=MaxRotateDegree){
      if(AzimuthTarget>Azimuth){
        Status=1; //digitalWrite(BrakePin, HIGH); delay(24);
        // RunTimer();
      }else{
        Status=-1; //digitalWrite(BrakePin, HIGH); delay(24);
        // RunTimer();
      }

    // escape from the forbidden zone
    }else if(Azimuth<0 && AzimuthTarget>0){
      Status=1; //digitalWrite(BrakePin, HIGH); delay(24);
      // RunTimer();
    }else if(Azimuth>MaxRotateDegree && AzimuthTarget<MaxRotateDegree){
      Status=-1; //digitalWrite(BrakePin, HIGH); delay(24);
      // RunTimer();
    }else{
      AzimuthTarget=-1;
      UiTargetAzimuth=-1;
    }
  }
}

//-------------------------------------------------------------------------------------------------------
void RunTimer(){
  StatusWatchdogTimer = millis();
  RotateWatchdogTimer = millis();
  AzimuthWatchdog=Azimuth;
}

//-------------------------------------------------------------------------------------------------------
void DetectEndstopZone(){
  if(Endstop==false){
    if(Status==-1 || Status==-11 || Status==-2 || Status==-21 || Status==-22 || Status==-23){  // run status CCW
      if(CcwRaw<CwRaw){ // standard az potentiometer
        if(AzimuthValue/1000>NoEndstopLowZone){
          // run
        }else{
          // MqttPubString("Debug", "2|"+String(Endstop)+"|"+String(AzimuthValue/1000)+"<"+String(NoEndstopHighZone), false);
          Status=-3;
        }
      }else{ // reverse az potentiometer value
        if(AzimuthValue/1000<NoEndstopHighZone){
          // run
        }else{
          // MqttPubString("Debug", "4|"+String(Endstop)+"|"+String(AzimuthValue/1000)+"<"+String(NoEndstopHighZone), false);
          Status=-3;
        }
      }
    }
    if(Status==1 || Status==11 || Status==2 || Status==21 || Status==22 || Status==23){  // run status CW
      if(CcwRaw<CwRaw){ // standard az potentiometer
        if(AzimuthValue/1000<NoEndstopHighZone){
          // run
        }else{
          // MqttPubString("Debug", "6|"+String(Endstop)+"|"+String(AzimuthValue/1000)+"<"+String(NoEndstopHighZone), false);
          Status=3;
        }
      }else{ // reverse az potentiometer value
        if(AzimuthValue/1000>NoEndstopLowZone){
          // run
        }else{
          // MqttPubString("Debug", "8|"+String(Endstop)+"|"+String(AzimuthValue/1000)+"<"+String(NoEndstopHighZone), false);
          Status=3;
        }
      }
    }
  }
}
//-------------------------------------------------------------------------------------------------------

void EthTest(){
  if(Status != 0 && eth_connected == false){
    Status=0;
  }   
}
//-------------------------------------------------------------------------------------------------------

float ClampFloat(float value, float minValue, float maxValue){
  if(value < minValue){
    return minValue;
  }
  if(value > maxValue){
    return maxValue;
  }
  return value;
}

byte ClampDuty(int value){
  if(value < 0){
    return 0;
  }
  if(value > 255){
    return 255;
  }
  return byte(value);
}

float ReadControlAzimuthDeg(){
  if(AZsource == 0){
    return AzimuthControlDeg;
  }
  return float(Azimuth);
}

float ReadRawAzimuthDeg(){
  if(AZsource == 0){
    return AzimuthRawDeg;
  }
  return float(Azimuth);
}

float ReadRemainingDistanceDeg(int directionSign, float azimuthDeg){
  if(AzimuthTarget < 0){
    return 0.0;
  }
  if(directionSign > 0){
    return float(AzimuthTarget) - azimuthDeg;
  }
  return azimuthDeg - float(AzimuthTarget);
}

float GetStopToleranceDeg(){
  if(AZsource != 0){
    return 0.6;
  }
  float tolerance = 0.35 + AzimuthNoiseDeg * 2.2;
  return ClampFloat(tolerance, 0.45, 1.6);
}

bool TargetReachedInDirection(int directionSign){
  return ReadRemainingDistanceDeg(directionSign, ReadRawAzimuthDeg()) <= GetStopToleranceDeg();
}

float GetPwmTuneAggressionFactor(){
  switch (PwmTuneAggressiveness) {
    case 0: { return 0.95f; }
    case 1: { return 1.40f; }
    case 2: { return 2.05f; }
    case 3: { return 2.85f; }
    default: { return 3.70f; }
  }
}

float GetPwmTuneLeadOffsetDeg(){
  switch (PwmTuneAggressiveness) {
    case 0: { return 0.00f; }
    case 1: { return 0.20f; }
    case 2: { return 0.45f; }
    case 3: { return 0.90f; }
    default: { return 1.40f; }
  }
}

bool ShouldForceStopFromPwmStall(int directionSign, byte currentDuty, float rawAzimuthDeg, byte maxDuty){
  static int trackedDirection = 0;
  static float stallStartAzimuthDeg = 0.0f;
  static unsigned long stallTimer = 0;

  int lowDutyThreshold = min(int(maxDuty), max(10, int(round(float(maxDuty) * 0.18f))));
  if(currentDuty > lowDutyThreshold){
    trackedDirection = 0;
    stallTimer = 0;
    stallStartAzimuthDeg = rawAzimuthDeg;
    return false;
  }

  if(trackedDirection != directionSign || stallTimer == 0){
    trackedDirection = directionSign;
    stallStartAzimuthDeg = rawAzimuthDeg;
    stallTimer = millis();
    return false;
  }

  if(abs(rawAzimuthDeg - stallStartAzimuthDeg) > 0.18f){
    stallStartAzimuthDeg = rawAzimuthDeg;
    stallTimer = millis();
    return false;
  }

  unsigned long lowDutyHoldMs = millis() - stallTimer;
  unsigned long brakeRampTimeoutMs = max(
    350UL,
    ((unsigned long)max(1, (int(currentDuty) + 9) / 10) * (unsigned long)max(1u, PwmRampSteps) * 11UL) / 10UL
  );

  if(lowDutyHoldMs > brakeRampTimeoutMs){
    return true;
  }

  return lowDutyHoldMs > 2500UL;
}

byte ComputeClosedLoopDuty(int directionSign){
  const byte pwmMinStart = 64;
  const byte pwmMinRun = 40;
  float stopToleranceDeg = GetStopToleranceDeg();
  float slowWindowDeg = max(PwmSlowWindowDeg, stopToleranceDeg + 1.0f);

  float remainingDeg = ReadRemainingDistanceDeg(directionSign, ReadControlAzimuthDeg()) - GetPwmTuneLeadOffsetDeg();
  if(remainingDeg <= stopToleranceDeg){
    return 0;
  }

  float normalized = (remainingDeg - stopToleranceDeg) / (slowWindowDeg - stopToleranceDeg);
  normalized = ClampFloat(normalized, 0.0, 1.0);

  float aggression = GetPwmTuneAggressionFactor();
  int maxDuty = int(PwmMaxDuty);
  float currentDutyRatio = (maxDuty > 0) ? ClampFloat(float(dutyCycle) / float(maxDuty), 0.0, 1.0) : 0.0;
  float brakeWindowShape = (0.24f + 0.76f * currentDutyRatio * currentDutyRatio) * (0.96f + aggression * 0.16f);
  float dynamicBrakeWindow = stopToleranceDeg + (slowWindowDeg - stopToleranceDeg) * ClampFloat(brakeWindowShape, 0.0, 1.30);
  float brakingUrgency = 0.0f;
  if(dynamicBrakeWindow > stopToleranceDeg){
    brakingUrgency = (dynamicBrakeWindow - remainingDeg) / (dynamicBrakeWindow - stopToleranceDeg);
    brakingUrgency = ClampFloat(brakingUrgency, 0.0, 1.0);
  }

  // When the current speed is too high for the remaining angle, bend the curve down
  // and allow a lower holding PWM so the stop ramp reacts sooner.
  normalized = powf(normalized, 1.0f + brakingUrgency * (1.35f + aggression * 0.95f));

  float minDutyReduction = ClampFloat(0.50f + aggression * 0.18f, 0.50f, 0.88f);
  int minDuty = min(maxDuty, max(8, int(round(float(pwmMinRun) * (1.0f - brakingUrgency * minDutyReduction)))));
  int targetDuty = minDuty + int((maxDuty - minDuty) * normalized);

  if(dutyCycle == 0 && targetDuty > 0){
    targetDuty = max(targetDuty, min(maxDuty, int(pwmMinStart)));
  }

  return ClampDuty(targetDuty);
}

void ApplyDutySlew(byte targetDuty, long &PwmTimer){
  unsigned int slewInterval = max(1u, PwmRampSteps);
  if(millis()-PwmTimer < slewInterval){
    return;
  }

  int nextDuty = dutyCycle;
  if(nextDuty < targetDuty){
    nextDuty += 10;
    if(nextDuty > targetDuty){
      nextDuty = targetDuty;
    }
  }else if(nextDuty > targetDuty){
    nextDuty -= 10;
    if(nextDuty < targetDuty){
      nextDuty = targetDuty;
    }
  }

  dutyCycle = ClampDuty(nextDuty);
  ledcWrite(mosfetPWMChannel, dutyCycle);
  PwmTimer=millis();
}

String FormatPwmTotalRampTime(unsigned int stepIntervalMs, byte maxDuty){
  unsigned int dutySteps = max(1, (int(maxDuty) + 9) / 10);
  unsigned long normalizedStepIntervalMs = (stepIntervalMs == 0) ? 1UL : static_cast<unsigned long>(stepIntervalMs);
  unsigned long totalRampMs = normalizedStepIntervalMs * static_cast<unsigned long>(dutySteps);

  if(totalRampMs >= 1000){
    return String(float(totalRampMs) / 1000.0f, 2) + " s total";
  }
  return String(totalRampMs) + " ms total";
}

bool IsSafeConfigChar(byte value){
  return value >= 32 && value <= 126;
}

bool IsSafeWebAuthPasswordValue(const String& value){
  for(size_t i = 0; i < value.length(); i++){
    char c = value[i];
    if(c == '"' || c == '\'' || c == '<' || c == '>' || c == '&'){
      return false;
    }
  }
  return true;
}

bool IsSafeMqttPublishTopicValue(const String& value){
  if(value.length() > 63){
    return false;
  }
  for(size_t i = 0; i < value.length(); i++){
    char c = value[i];
    if(c < 32 || c > 126 || c == '+' || c == '#'){
      return false;
    }
  }
  return true;
}

bool LooksLikeLegacyWebAuthKey(const String& value){
  if(value.length() != 100){
    return false;
  }
  for(size_t i = 0; i < value.length(); i++){
    char c = value[i];
    bool isDigit = (c >= '0' && c <= '9');
    bool isUpper = (c >= 'A' && c <= 'Z');
    bool isLower = (c >= 'a' && c <= 'z');
    if(!(isDigit || isUpper || isLower)){
      return false;
    }
  }
  return true;
}

String ReadFixedStringFromEeprom(int start, int length){
  String value = "";
  value.reserve(length);
  for(int i = 0; i < length; i++){
    byte raw = EEPROM.read(start + i);
    if(raw == 0xff || raw == 0x00){
      break;
    }
    if(IsSafeConfigChar(raw)){
      value += char(raw);
    }
  }
  return value;
}

void WriteFixedStringToEeprom(int start, int length, const String& text){
  for(int i = 0; i < length; i++){
    EEPROM.write(start + i, (i < text.length()) ? text[i] : 0xff);
  }
}

// Normalize a TrxNet priority-prefix string: trim, collapse internal whitespace to
// single spaces, keep only printable ASCII within tokens, and clamp to
// TRXNET_PRIO_MAX_PREFIXES x TRXNET_PRIO_MAX_LEN. Returns the clamped result and,
// via *valid, whether the ORIGINAL input already fit the limits (no illegal char,
// no over-long token, no excess token). The interactive setup form uses *valid to
// hard-reject; config-backup import ignores it and takes the clamped string.
String NormalizeTrxNetPrio(const String& in, bool* valid){
  bool ok = true;
  String out = "";
  int tokenCount = 0;
  int i = 0;
  int n = in.length();
  while(i < n){
    while(i < n && in[i] == ' ') i++;              // skip separators (collapse)
    if(i >= n) break;
    String tok = "";
    while(i < n && in[i] != ' '){
      char c = in[i];
      if(IsSafeConfigChar((byte)c)){
        if(tok.length() < TRXNET_PRIO_MAX_LEN){
          tok += c;
        }else{
          ok = false;                              // token longer than max -> clamp
        }
      }else{
        ok = false;                                // illegal char dropped
      }
      i++;
    }
    if(tok.length() == 0) continue;
    if(tokenCount >= TRXNET_PRIO_MAX_PREFIXES){
      ok = false;                                  // too many tokens -> dropped
      continue;
    }
    if(out.length() > 0) out += " ";
    out += tok;
    tokenCount++;
  }
  if(valid) *valid = ok;
  return out;
}

// Tokenize TrxNetPrio into the global buffer/pointer array handed to
// net.setPriorityPrefixes(). Spaces become '\0' so each pointer is a C string that
// stays valid for the net object's lifetime. Assumes TrxNetPrio is already
// normalized, but is bounded and safe even if not.
void ParseTrxNetPrio(){
  TrxNetPrioCount = 0;
  memset(TrxNetPrioBuf, 0, sizeof(TrxNetPrioBuf));
  int len = TrxNetPrio.length();
  if(len > (int)sizeof(TrxNetPrioBuf) - 1) len = sizeof(TrxNetPrioBuf) - 1;
  for(int i = 0; i < len; i++) TrxNetPrioBuf[i] = TrxNetPrio[i];
  TrxNetPrioBuf[len] = '\0';
  int i = 0;
  while(i < len && TrxNetPrioCount < TRXNET_PRIO_MAX_PREFIXES){
    while(i < len && TrxNetPrioBuf[i] == ' '){ TrxNetPrioBuf[i] = '\0'; i++; }
    if(i >= len) break;
    TrxNetPrioPtrs[TrxNetPrioCount++] = &TrxNetPrioBuf[i];
    while(i < len && TrxNetPrioBuf[i] != ' ') i++;
  }
}

String JsonEscape(const String& value){
  String escaped = "";
  escaped.reserve(value.length() + 8);
  for(size_t i = 0; i < value.length(); i++){
    unsigned char c = static_cast<unsigned char>(value[i]);
    switch(c){
      case '\\': escaped += "\\\\"; break;
      case '"': escaped += "\\\""; break;
      case '\n': escaped += "\\n"; break;
      case '\r': escaped += "\\r"; break;
      case '\t': escaped += "\\t"; break;
      default:
        if(c < 0x20){
          const char* hex = "0123456789ABCDEF";
          escaped += "\\u00";
          escaped += hex[(c >> 4) & 0x0F];
          escaped += hex[c & 0x0F];
        }else{
          escaped += char(c);
        }
        break;
    }
  }
  return escaped;
}

static int FindJsonValueStart(const String& json, const char* key){
  String needle = String("\"") + key + "\"";
  int keyPos = json.indexOf(needle);
  if(keyPos < 0){
    return -1;
  }
  int colonPos = json.indexOf(':', keyPos + needle.length());
  if(colonPos < 0){
    return -1;
  }
  int valuePos = colonPos + 1;
  while(valuePos < json.length() && isspace(static_cast<unsigned char>(json[valuePos]))){
    valuePos++;
  }
  if(valuePos >= json.length()){
    return -1;
  }
  return valuePos;
}

bool JsonExtractString(const String& json, const char* key, String& value){
  int valuePos = FindJsonValueStart(json, key);
  if(valuePos < 0 || json[valuePos] != '"'){
    return false;
  }
  value = "";
  for(int i = valuePos + 1; i < json.length(); i++){
    char c = json[i];
    if(c == '\\'){
      if(i + 1 >= json.length()){
        return false;
      }
      char next = json[++i];
      switch(next){
        case '"': value += '"'; break;
        case '\\': value += '\\'; break;
        case 'n': value += '\n'; break;
        case 'r': value += '\r'; break;
        case 't': value += '\t'; break;
        default: value += next; break;
      }
    }else if(c == '"'){
      return true;
    }else{
      value += c;
    }
  }
  return false;
}

bool JsonExtractLong(const String& json, const char* key, long& value){
  int valuePos = FindJsonValueStart(json, key);
  if(valuePos < 0){
    return false;
  }
  int endPos = valuePos;
  while(endPos < json.length()){
    char c = json[endPos];
    if((c >= '0' && c <= '9') || c == '-' || c == '+'){
      endPos++;
    }else{
      break;
    }
  }
  if(endPos == valuePos){
    return false;
  }
  value = json.substring(valuePos, endPos).toInt();
  return true;
}

bool JsonExtractFloat(const String& json, const char* key, float& value){
  int valuePos = FindJsonValueStart(json, key);
  if(valuePos < 0){
    return false;
  }
  int endPos = valuePos;
  while(endPos < json.length()){
    char c = json[endPos];
    if((c >= '0' && c <= '9') || c == '-' || c == '+' || c == '.'){
      endPos++;
    }else{
      break;
    }
  }
  if(endPos == valuePos){
    return false;
  }
  value = json.substring(valuePos, endPos).toFloat();
  return true;
}

bool JsonExtractBool(const String& json, const char* key, bool& value){
  int valuePos = FindJsonValueStart(json, key);
  if(valuePos < 0){
    return false;
  }
  if(json.startsWith("true", valuePos)){
    value = true;
    return true;
  }
  if(json.startsWith("false", valuePos)){
    value = false;
    return true;
  }
  return false;
}

String ExportConfigBackupJson(){
  String json = "{\n";
  json += "  \"format\": \"" CONFIG_BACKUP_FORMAT "\",\n";
  json += "  \"version\": " + String(CONFIG_BACKUP_VERSION) + ",\n";
  json += "  \"fw_rev\": \"" + JsonEscape(String(REV)) + "\",\n";
  json += "  \"config\": {\n";
  json += "    \"net_id\": \"" + JsonEscape(NET_ID) + "\",\n";
  json += "    \"rot_name\": \"" + JsonEscape(RotName) + "\",\n";
  json += "    \"your_call\": \"" + JsonEscape(YOUR_CALL) + "\",\n";
  json += "    \"start_azimuth\": " + String(StartAzimuth) + ",\n";
  json += "    \"max_rotate_degree\": " + String(MaxRotateDegree) + ",\n";
  json += "    \"ant_radiation_angle\": " + String(AntRadiationAngle) + ",\n";
  json += "    \"endstop\": " + String(Endstop ? "true" : "false") + ",\n";
  json += "    \"ac_motor\": " + String(ACmotor ? "true" : "false") + ",\n";
  json += "    \"ccw_raw\": " + String(CcwRaw) + ",\n";
  json += "    \"cw_raw\": " + String(CwRaw) + ",\n";
  json += "    \"reverse\": " + String(Reverse ? "true" : "false") + ",\n";
  json += "    \"no_endstop_low_zone\": " + String(NoEndstopLowZone, 1) + ",\n";
  json += "    \"no_endstop_high_zone\": " + String(NoEndstopHighZone, 1) + ",\n";
  json += "    \"az_source\": " + String(AZsource) + ",\n";
  json += "    \"pulse_per_degree\": " + String(PulsePerDegree) + ",\n";
  json += "    \"baud_rate\": " + String(BaudRate) + ",\n";
  json += "    \"az_two_wire\": " + String(AZtwoWire ? "true" : "false") + ",\n";
  json += "    \"az_preamp\": " + String(AZpreamp ? "true" : "false") + ",\n";
  json += "    \"reverse_az\": " + String(ReverseAZ ? "true" : "false") + ",\n";
  json += "    \"web_auth_enabled\": " + String(WebAuthEnabled ? "true" : "false") + ",\n";
  json += "    \"web_auth_password\": \"" + JsonEscape(WebAuthPassword) + "\",\n";
  json += "    \"pwm_enable\": " + String(PWMenable ? "true" : "false") + ",\n";
  json += "    \"pwm_ramp_steps\": " + String(PwmRampSteps) + ",\n";
  json += "    \"pwm_max_duty\": " + String(PwmMaxDuty) + ",\n";
  json += "    \"pwm_slow_window_deg\": " + String(PwmSlowWindowDeg, 1) + ",\n";
  json += "    \"pwm_tune_aggressiveness\": " + String(PwmTuneAggressiveness) + ",\n";
  json += "    \"mqtt_ip\": \"" + String(mqtt_server_ip[0]) + "." + String(mqtt_server_ip[1]) + "." + String(mqtt_server_ip[2]) + "." + String(mqtt_server_ip[3]) + "\",\n";
  json += "    \"mqtt_port\": " + String(MQTT_PORT) + ",\n";
  json += "    \"mqtt_login\": " + String(MQTT_LOGIN ? "true" : "false") + ",\n";
  json += "    \"mqtt_user\": \"" + JsonEscape(MQTT_USER) + "\",\n";
  json += "    \"mqtt_pass\": \"" + JsonEscape(MQTT_PASS) + "\",\n";
  json += "    \"dxc_host\": \"" + JsonEscape(DxcHost) + "\",\n";
  json += "    \"dxc_port\": " + String(DxcPort) + ",\n";
  json += "    \"dxc_callsign\": \"" + JsonEscape(DxcCallsign) + "\",\n";
  json += "    \"dxc_mqtt_topic\": \"" + JsonEscape(DxcMqttTopic) + "\",\n";
  json += "    \"dxc_mqtt_topic_middle\": \"" + JsonEscape(DxcMqttTopicMiddle) + "\",\n";
  json += "    \"dxc_mqtt_topic_right\": \"" + JsonEscape(DxcMqttTopicRight) + "\",\n";
  json += "    \"elevation\": " + String(ELEVATION ? "true" : "false") + ",\n";
  json += "    \"map_url\": \"" + JsonEscape(MapUrl) + "\",\n";
  json += "    \"map_source\": " + String(MapSource) + ",\n";
  json += "    \"map_locator\": \"" + JsonEscape(MapLocator) + "\",\n";
  json += "    \"map_zoom_km\": " + String(MapZoomKm) + ",\n";
  json += "    \"grayline_ntp_server\": \"" + JsonEscape(GraylineNtpServer) + "\",\n";
  json += "    \"grayline_darkness\": " + String(GraylineDarkness) + ",\n";
  json += "    \"map_theme\": " + String(MapTheme) + ",\n";
  json += "    \"default_deg_overlay\": " + String(DefaultDegOverlayEnabled ? "true" : "false") + ",\n";
  json += "    \"default_ant_overlay\": " + String(DefaultAntOverlayEnabled ? "true" : "false") + ",\n";
  json += "    \"default_loc_grid\": " + String(DefaultMapLocGridEnabled ? "true" : "false") + ",\n";
  json += "    \"default_grayline\": " + String(DefaultMapGraylineEnabled ? "true" : "false") + ",\n";
  json += "    \"default_state_borders\": " + String(DefaultMapBordersEnabled ? "true" : "false") + ",\n";
  json += "    \"default_dxcc_prefixes\": " + String(DefaultMapDxccEnabled ? "true" : "false") + ",\n";
  json += "    \"default_dxc_spots\": " + String(DefaultMapDxcSpotsEnabled ? "true" : "false") + ",\n";
  json += "    \"default_dxc_lines\": " + String(DefaultMapDxcLinesEnabled ? "true" : "false") + ",\n";
  json += "    \"one_turn_limit_sec\": " + String(OneTurnLimitSec) + ",\n";
  json += "    \"trxnet_port\": " + String(TrxNetPort) + ",\n";
  json += "    \"trxnet_sub\": " + String(TrxNetSubEnabled ? "true" : "false") + ",\n";
  json += "    \"trxnet_prio\": \"" + JsonEscape(TrxNetPrio) + "\",\n";
  json += "    \"dxc_wifilt_enabled\": " + String(DxcWifiltEnabled ? "true" : "false") + "\n";
  json += "  }\n";
  json += "}\n";
  return json;
}

String ImportConfigBackupJson(const String& jsonPayload){
  String format;
  long version = 0;
  if(!JsonExtractString(jsonPayload, "format", format) || format != CONFIG_BACKUP_FORMAT){
    return "Invalid backup format";
  }
  if(!JsonExtractLong(jsonPayload, "version", version) || version != CONFIG_BACKUP_VERSION){
    return "Unsupported backup version";
  }

  String newNetId, newRotName, newYourCall, newMapUrl, newMqttUser, newMqttPass, newMapLocator, newGraylineNtp, mqttIpText, newDxcHost, newDxcCallsign, newDxcMqttTopic, newDxcMqttTopicMiddle, newDxcMqttTopicRight, newWebAuthPassword;
  long startAzimuthValue = 0, maxRotateValue = 0, antAngleValue = 0, ccwRawValue = 0, cwRawValue = 0;
  long azSourceValue = 0, pulsePerDegreeValue = 0, baudRateValue = 0, pwmRampStepsValue = 0, pwmMaxDutyValue = 0;
  long pwmTuneValue = 0, mqttPortValue = 0, dxcPortValue = 0, mapSourceValue = 0, mapZoomValue = 0, graylineDarknessValue = 0, mapThemeValue = 0, oneTurnLimitValue = 0;
  float lowZoneValue = 0.0f, highZoneValue = 0.0f, pwmSlowWindowValue = 0.0f;
  bool endstopValue = false, acMotorValue = false, reverseValue = false, azTwoWireValue = false, azPreampValue = false;
  bool reverseAzValue = false, webAuthEnabledValue = false, pwmEnableValue = false, mqttLoginValue = false, elevationValue = false;
  long trxNetPortValue = 5683;
  bool trxNetSubValue = false;
  String trxNetPrioValue = "INK 705";
  bool defaultDegOverlayValue = true, defaultAntOverlayValue = true, defaultLocGridValue = false, defaultGraylineValue = true, defaultStateBordersValue = false, defaultDxccPrefixesValue = false, defaultDxcSpotsValue = false, defaultDxcLinesValue = false;

  if(!JsonExtractString(jsonPayload, "net_id", newNetId) || newNetId.length() < 1 || newNetId.length() > 2){
    return "Invalid net_id";
  }
  if(!JsonExtractString(jsonPayload, "rot_name", newRotName) || newRotName.length() < 1 || newRotName.length() > 20){
    return "Invalid rot_name";
  }
  if(!JsonExtractString(jsonPayload, "your_call", newYourCall) || newYourCall.length() < 1 || newYourCall.length() > 20){
    return "Invalid your_call";
  }
  if(!JsonExtractLong(jsonPayload, "start_azimuth", startAzimuthValue) || startAzimuthValue < 0 || startAzimuthValue > 359){
    return "Invalid start_azimuth";
  }
  if(!JsonExtractLong(jsonPayload, "max_rotate_degree", maxRotateValue) || maxRotateValue < 0 || maxRotateValue > 719){
    return "Invalid max_rotate_degree";
  }
  if(!JsonExtractLong(jsonPayload, "ant_radiation_angle", antAngleValue) || antAngleValue < 1 || antAngleValue > 180){
    return "Invalid ant_radiation_angle";
  }
  if(!JsonExtractBool(jsonPayload, "endstop", endstopValue)){
    return "Invalid endstop";
  }
  if(!JsonExtractBool(jsonPayload, "ac_motor", acMotorValue)){
    return "Invalid ac_motor";
  }
  if(!JsonExtractLong(jsonPayload, "ccw_raw", ccwRawValue) || ccwRawValue < 0 || ccwRawValue > 4095){
    return "Invalid ccw_raw";
  }
  if(!JsonExtractLong(jsonPayload, "cw_raw", cwRawValue) || cwRawValue < 0 || cwRawValue > 4095){
    return "Invalid cw_raw";
  }
  if(!JsonExtractBool(jsonPayload, "reverse", reverseValue)){
    return "Invalid reverse";
  }
  if(!JsonExtractFloat(jsonPayload, "no_endstop_low_zone", lowZoneValue) || lowZoneValue < 0.2f || lowZoneValue > 1.5f){
    return "Invalid no_endstop_low_zone";
  }
  if(!JsonExtractFloat(jsonPayload, "no_endstop_high_zone", highZoneValue) || highZoneValue < 1.6f || highZoneValue > 3.1f){
    return "Invalid no_endstop_high_zone";
  }
  if(!JsonExtractLong(jsonPayload, "az_source", azSourceValue) || azSourceValue < 0 || azSourceValue > 2){
    return "Invalid az_source";
  }
  if(!JsonExtractLong(jsonPayload, "pulse_per_degree", pulsePerDegreeValue) || pulsePerDegreeValue < 1 || pulsePerDegreeValue > 100){
    return "Invalid pulse_per_degree";
  }
  if(!JsonExtractLong(jsonPayload, "baud_rate", baudRateValue) || (baudRateValue != 1200 && baudRateValue != 2400 && baudRateValue != 4800 && baudRateValue != 9600 && baudRateValue != 115200)){
    return "Invalid baud_rate";
  }
  if(!JsonExtractBool(jsonPayload, "az_two_wire", azTwoWireValue)){
    return "Invalid az_two_wire";
  }
  if(!JsonExtractBool(jsonPayload, "az_preamp", azPreampValue)){
    return "Invalid az_preamp";
  }
  if(!JsonExtractBool(jsonPayload, "reverse_az", reverseAzValue)){
    return "Invalid reverse_az";
  }
  if(!JsonExtractBool(jsonPayload, "web_auth_enabled", webAuthEnabledValue)){
    webAuthEnabledValue = false;
  }
  if(!JsonExtractString(jsonPayload, "web_auth_password", newWebAuthPassword)){
    newWebAuthPassword = WebAuthPassword;
  }
  if(newWebAuthPassword.length() > 100 || !IsSafeWebAuthPasswordValue(newWebAuthPassword)){
    return "Invalid web_auth_password";
  }
  if(webAuthEnabledValue && newWebAuthPassword.length() < 1){
    return "web_auth_password is required when web_auth_enabled is true";
  }
  if(!JsonExtractBool(jsonPayload, "pwm_enable", pwmEnableValue)){
    return "Invalid pwm_enable";
  }
  if(!JsonExtractLong(jsonPayload, "pwm_ramp_steps", pwmRampStepsValue) || pwmRampStepsValue < 1 || pwmRampStepsValue > 200){
    return "Invalid pwm_ramp_steps";
  }
  if(!JsonExtractLong(jsonPayload, "pwm_max_duty", pwmMaxDutyValue) || pwmMaxDutyValue < 40 || pwmMaxDutyValue > 255){
    return "Invalid pwm_max_duty";
  }
  if(!JsonExtractFloat(jsonPayload, "pwm_slow_window_deg", pwmSlowWindowValue) || pwmSlowWindowValue < 3.0f || pwmSlowWindowValue > 60.0f){
    return "Invalid pwm_slow_window_deg";
  }
  if(!JsonExtractLong(jsonPayload, "pwm_tune_aggressiveness", pwmTuneValue) || pwmTuneValue < 0 || pwmTuneValue > 4){
    return "Invalid pwm_tune_aggressiveness";
  }
  if(!JsonExtractString(jsonPayload, "mqtt_ip", mqttIpText)){
    return "Invalid mqtt_ip";
  }
  if(!JsonExtractLong(jsonPayload, "mqtt_port", mqttPortValue) || mqttPortValue < 1 || mqttPortValue > 65535){
    return "Invalid mqtt_port";
  }
  if(!JsonExtractBool(jsonPayload, "mqtt_login", mqttLoginValue)){
    return "Invalid mqtt_login";
  }
  if(!JsonExtractString(jsonPayload, "mqtt_user", newMqttUser) || newMqttUser.length() < 1 || newMqttUser.length() > 10){
    return "Invalid mqtt_user";
  }
  if(!JsonExtractString(jsonPayload, "mqtt_pass", newMqttPass) || newMqttPass.length() < 1 || newMqttPass.length() > 20){
    return "Invalid mqtt_pass";
  }
  if(!JsonExtractString(jsonPayload, "dxc_host", newDxcHost) || newDxcHost.length() > 63){
    return "Invalid dxc_host";
  }
  if(!JsonExtractLong(jsonPayload, "dxc_port", dxcPortValue) || dxcPortValue < 1 || dxcPortValue > 65535){
    return "Invalid dxc_port";
  }
  if(!JsonExtractString(jsonPayload, "dxc_callsign", newDxcCallsign) || newDxcCallsign.length() > 16){
    return "Invalid dxc_callsign";
  }
  if(!JsonExtractString(jsonPayload, "dxc_mqtt_topic", newDxcMqttTopic)){
    newDxcMqttTopic = "";
  }
  if(!JsonExtractString(jsonPayload, "dxc_mqtt_topic_middle", newDxcMqttTopicMiddle)){
    newDxcMqttTopicMiddle = "";
  }
  if(!JsonExtractString(jsonPayload, "dxc_mqtt_topic_right", newDxcMqttTopicRight)){
    newDxcMqttTopicRight = "";
  }
  newDxcHost.trim();
  newDxcCallsign.trim();
  newDxcCallsign.toUpperCase();
  newDxcMqttTopic.trim();
  newDxcMqttTopicMiddle.trim();
  newDxcMqttTopicRight.trim();
  if(newDxcHost.length() > 0 && newDxcCallsign.length() < 1){
    return "DXC callsign is required when dxc_host is set";
  }
  if(!IsSafeMqttPublishTopicValue(newDxcMqttTopic)){
    return "Invalid dxc_mqtt_topic";
  }
  if(!IsSafeMqttPublishTopicValue(newDxcMqttTopicMiddle)){
    return "Invalid dxc_mqtt_topic_middle";
  }
  if(!IsSafeMqttPublishTopicValue(newDxcMqttTopicRight)){
    return "Invalid dxc_mqtt_topic_right";
  }
  if(!JsonExtractBool(jsonPayload, "elevation", elevationValue)){
    return "Invalid elevation";
  }
  // Added after CONFIG_BACKUP_VERSION 1 shipped - optional, so backups written by
  // older firmware still restore instead of failing on a missing key.
  bool dxcWifiltEnabledValue = DxcWifiltEnabled;
  JsonExtractBool(jsonPayload, "dxc_wifilt_enabled", dxcWifiltEnabledValue);
  if(!JsonExtractString(jsonPayload, "map_url", newMapUrl) || newMapUrl.length() < 1 || newMapUrl.length() > 50){
    return "Invalid map_url";
  }
  if(!JsonExtractLong(jsonPayload, "map_source", mapSourceValue) || mapSourceValue < 0 || mapSourceValue > 1){
    return "Invalid map_source";
  }
  if(!JsonExtractString(jsonPayload, "map_locator", newMapLocator)){
    return "Invalid map_locator";
  }
  newMapLocator.trim();
  newMapLocator.toUpperCase();
  if(newMapLocator.length()!=6 || newMapLocator[0]<'A' || newMapLocator[0]>'R' || newMapLocator[1]<'A' || newMapLocator[1]>'R' || newMapLocator[2]<'0' || newMapLocator[2]>'9' || newMapLocator[3]<'0' || newMapLocator[3]>'9' || newMapLocator[4]<'A' || newMapLocator[4]>'X' || newMapLocator[5]<'A' || newMapLocator[5]>'X'){
    return "Invalid map_locator";
  }
  if(!JsonExtractLong(jsonPayload, "map_zoom_km", mapZoomValue) || mapZoomValue < 1000 || mapZoomValue > 20000){
    return "Invalid map_zoom_km";
  }
  if(!JsonExtractString(jsonPayload, "grayline_ntp_server", newGraylineNtp) || newGraylineNtp.length() < 1 || newGraylineNtp.length() > 50){
    return "Invalid grayline_ntp_server";
  }
  if(!JsonExtractLong(jsonPayload, "grayline_darkness", graylineDarknessValue) || graylineDarknessValue < 0 || graylineDarknessValue > 100){
    return "Invalid grayline_darkness";
  }
  if(!JsonExtractLong(jsonPayload, "map_theme", mapThemeValue) || mapThemeValue < 0 || mapThemeValue > 5){
    return "Invalid map_theme";
  }
  if(!JsonExtractBool(jsonPayload, "default_deg_overlay", defaultDegOverlayValue)){
    defaultDegOverlayValue = true;
  }
  if(!JsonExtractBool(jsonPayload, "default_ant_overlay", defaultAntOverlayValue)){
    defaultAntOverlayValue = true;
  }
  if(!JsonExtractBool(jsonPayload, "default_loc_grid", defaultLocGridValue)){
    defaultLocGridValue = false;
  }
  if(!JsonExtractBool(jsonPayload, "default_grayline", defaultGraylineValue)){
    defaultGraylineValue = true;
  }
  if(!JsonExtractBool(jsonPayload, "default_state_borders", defaultStateBordersValue)){
    defaultStateBordersValue = false;
  }
  if(!JsonExtractBool(jsonPayload, "default_dxcc_prefixes", defaultDxccPrefixesValue)){
    defaultDxccPrefixesValue = false;
  }
  if(!JsonExtractBool(jsonPayload, "default_dxc_spots", defaultDxcSpotsValue)){
    defaultDxcSpotsValue = false;
  }
  if(!JsonExtractBool(jsonPayload, "default_dxc_lines", defaultDxcLinesValue)){
    defaultDxcLinesValue = false;
  }
  if(!JsonExtractLong(jsonPayload, "one_turn_limit_sec", oneTurnLimitValue) || oneTurnLimitValue < 20 || oneTurnLimitValue > 600){
    return "Invalid one_turn_limit_sec";
  }
  JsonExtractLong(jsonPayload, "trxnet_port", trxNetPortValue);
  if(trxNetPortValue < 1024 || trxNetPortValue > 65535) trxNetPortValue = 5683;
  JsonExtractBool(jsonPayload, "trxnet_sub", trxNetSubValue);
  // Soft sanitize on import (no interactive UI to reject): clamp to 8 x 8 chars.
  if(JsonExtractString(jsonPayload, "trxnet_prio", trxNetPrioValue)){
    trxNetPrioValue = NormalizeTrxNetPrio(trxNetPrioValue, NULL);
  }

  int mqttIp0 = -1, mqttIp1 = -1, mqttIp2 = -1, mqttIp3 = -1;
  if(sscanf(mqttIpText.c_str(), "%d.%d.%d.%d", &mqttIp0, &mqttIp1, &mqttIp2, &mqttIp3) != 4){
    return "Invalid mqtt_ip";
  }
  if(mqttIp0 < 0 || mqttIp0 > 255 || mqttIp1 < 0 || mqttIp1 > 255 || mqttIp2 < 0 || mqttIp2 > 255 || mqttIp3 < 0 || mqttIp3 > 255){
    return "Invalid mqtt_ip";
  }

  if(elevationValue && maxRotateValue > 180){
    return "Elevation backup requires max_rotate_degree in range 0-180";
  }

  int lowZoneTenths = int(lowZoneValue * 10.0f + 0.5f);
  int highZoneTenths = int(highZoneValue * 10.0f + 0.5f);
  int pwmSlowWindowTenths = int(pwmSlowWindowValue * 10.0f + 0.5f);

  YOUR_CALL = newYourCall;
  NET_ID = newNetId;
  RotName = newRotName;
  StartAzimuth = startAzimuthValue;
  MaxRotateDegree = maxRotateValue;
  AntRadiationAngle = antAngleValue;
  Endstop = ((azSourceValue == 1 || azSourceValue == 2) ? true : endstopValue);
  ACmotor = acMotorValue;
  CcwRaw = ccwRawValue;
  CwRaw = cwRawValue;
  Reverse = reverseValue;
  NoEndstopLowZone = float(lowZoneTenths) / 10.0f;
  NoEndstopHighZone = float(highZoneTenths) / 10.0f;
  AZsource = byte(azSourceValue);
  PulsePerDegree = pulsePerDegreeValue;
  BaudRate = baudRateValue;
  AZtwoWire = azTwoWireValue;
  AZpreamp = azPreampValue;
  ReverseAZ = reverseAzValue;
  WebAuthEnabled = webAuthEnabledValue;
  WebAuthPassword = newWebAuthPassword;
  PWMenable = pwmEnableValue && !ACmotor;
  PwmRampSteps = pwmRampStepsValue;
  PwmMaxDuty = pwmMaxDutyValue;
  PwmSlowWindowDeg = float(pwmSlowWindowTenths) / 10.0f;
  PwmTuneAggressiveness = pwmTuneValue;
  mqtt_server_ip[0] = byte(mqttIp0);
  mqtt_server_ip[1] = byte(mqttIp1);
  mqtt_server_ip[2] = byte(mqttIp2);
  mqtt_server_ip[3] = byte(mqttIp3);
  MQTT_PORT = mqttPortValue;
  MQTT_LOGIN = mqttLoginValue;
  MQTT_USER = newMqttUser;
  MQTT_PASS = newMqttPass;
  DxcHost = newDxcHost;
  DxcPort = uint16_t(dxcPortValue);
  DxcCallsign = newDxcCallsign;
  DxcMqttTopic = newDxcMqttTopic;
  DxcMqttTopicMiddle = newDxcMqttTopicMiddle;
  DxcMqttTopicRight = newDxcMqttTopicRight;
  DxcWifiltEnabled = dxcWifiltEnabledValue;
  ELEVATION = elevationValue;
  MapUrl = newMapUrl;
  MapSource = byte(mapSourceValue);
  MapLocator = newMapLocator;
  MapZoomKm = mapZoomValue;
  GraylineNtpServer = newGraylineNtp;
  GraylineDarkness = byte(graylineDarknessValue);
  MapTheme = byte(mapThemeValue);
  DefaultDegOverlayEnabled = defaultDegOverlayValue;
  DefaultAntOverlayEnabled = defaultAntOverlayValue;
  DefaultMapLocGridEnabled = defaultLocGridValue;
  DefaultMapGraylineEnabled = defaultGraylineValue;
  DefaultMapBordersEnabled = defaultStateBordersValue;
  DefaultMapDxccEnabled = defaultDxccPrefixesValue;
  DefaultMapDxcSpotsEnabled = defaultDxcSpotsValue;
  DefaultMapDxcLinesEnabled = defaultDxcLinesValue;
  OneTurnLimitSec = oneTurnLimitValue;
  TrxNetPort = uint16_t(trxNetPortValue);
  TrxNetSubEnabled = trxNetSubValue;
  TrxNetPrio = trxNetPrioValue;

  WriteFixedStringToEeprom(0, 2, NET_ID);
  WriteFixedStringToEeprom(2, 20, RotName);
  EEPROM.writeUShort(23, StartAzimuth);
  EEPROM.writeUShort(25, MaxRotateDegree);
  EEPROM.writeUShort(27, AntRadiationAngle);
  EEPROM.writeBool(29, Endstop);
  EEPROM.writeBool(30, ACmotor);
  EEPROM.writeUShort(31, CcwRaw);
  EEPROM.writeUShort(33, CwRaw);
  EEPROM.writeBool(35, Reverse);
  EEPROM.writeByte(36, lowZoneTenths);
  WriteFixedStringToEeprom(141, 20, YOUR_CALL);
  EEPROM.writeByte(161, mqtt_server_ip[0]);
  EEPROM.writeByte(162, mqtt_server_ip[1]);
  EEPROM.writeByte(163, mqtt_server_ip[2]);
  EEPROM.writeByte(164, mqtt_server_ip[3]);
  EEPROM.writeUShort(165, MQTT_PORT);
  EEPROM.writeBool(167, ELEVATION);
  EEPROM.writeBool(168, MQTT_LOGIN);
  WriteFixedStringToEeprom(169, 50, MapUrl);
  EEPROM.writeUShort(220, OneTurnLimitSec);
  EEPROM.writeByte(222, highZoneTenths);
  EEPROM.writeByte(223, AZsource);
  EEPROM.writeUShort(224, PulsePerDegree);
  EEPROM.writeUShort(226, BaudRate);
  EEPROM.writeBool(228, AZtwoWire);
  EEPROM.writeBool(229, AZpreamp);
  EEPROM.writeBool(230, ReverseAZ);
  EEPROM.writeBool(231, PWMenable);
  EEPROM.writeBool(232, WebAuthEnabled);
  EEPROM.writeByte(233, 0xA5);
  WriteFixedStringToEeprom(41, 100, WebAuthPassword);
  EEPROM.writeUShort(234, PwmRampSteps);
  WriteFixedStringToEeprom(236, 10, MQTT_USER);
  WriteFixedStringToEeprom(246, 20, MQTT_PASS);
  EEPROM.writeByte(266, MapSource);
  for(int i = 0; i < 6; i++){
    EEPROM.write(267 + i, MapLocator[i]);
  }
  EEPROM.writeUShort(273, MapZoomKm);
  WriteFixedStringToEeprom(275, 50, GraylineNtpServer);
  EEPROM.writeByte(325, GraylineDarkness);
  EEPROM.writeByte(326, MapTheme);
  EEPROM.writeByte(327, PwmMaxDuty);
  EEPROM.writeUShort(328, pwmSlowWindowTenths);
  EEPROM.writeByte(330, PwmTuneAggressiveness);
  WriteFixedStringToEeprom(331, 64, DxcHost);
  EEPROM.writeUShort(395, DxcPort);
  WriteFixedStringToEeprom(397, 16, DxcCallsign);
  WriteFixedStringToEeprom(422, 64, DxcMqttTopic);
  WriteFixedStringToEeprom(487, 64, DxcMqttTopicMiddle);
  WriteFixedStringToEeprom(551, 64, DxcMqttTopicRight);
  EEPROM.writeBool(691, DxcWifiltEnabled);
  EEPROM.writeUShort(615, TrxNetPort);
  EEPROM.writeBool(617, TrxNetSubEnabled);
  WriteFixedStringToEeprom(618, 72, TrxNetPrio);
  EEPROM.write(690, 0x01);
  EEPROM.writeBool(413, DefaultDegOverlayEnabled);
  EEPROM.writeBool(414, DefaultAntOverlayEnabled);
  EEPROM.writeBool(415, DefaultMapLocGridEnabled);
  EEPROM.writeBool(416, DefaultMapGraylineEnabled);
  EEPROM.writeBool(417, DefaultMapBordersEnabled);
  EEPROM.writeBool(418, DefaultMapDxccEnabled);
  EEPROM.writeBool(419, DefaultMapDxcSpotsEnabled);
  EEPROM.writeBool(486, DefaultMapDxcLinesEnabled);
  EEPROM.commit();

  digitalWrite(AZtwoWirePin, AZtwoWire);
  digitalWrite(AZpreampPin, AZpreamp);
  ApplyAzimuthSourceMode(false);
  ApplyGraylineNtpConfig();
  return "";
}

void MaybeBeginBrakeLearning(int directionSign, bool &brakeLearningActive, int &brakeLearningDirection, float &brakeStartDistance){
  if(brakeLearningActive || AZsource != 0 || PWMenable == false || AzimuthTarget < 0){
    return;
  }

  float stopToleranceDeg = GetStopToleranceDeg();
  float slowWindowDeg = max(PwmSlowWindowDeg, stopToleranceDeg + 1.0f);
  float rawRemainingDeg = ReadRemainingDistanceDeg(directionSign, ReadRawAzimuthDeg());
  if(rawRemainingDeg <= 0.0f || rawRemainingDeg > slowWindowDeg + 0.8f){
    return;
  }

  brakeLearningActive = true;
  brakeLearningDirection = directionSign;
  brakeStartDistance = rawRemainingDeg;
}

void UpdateAutoSlowWindow(float brakeStartDistance, float finalDistance){
  if(AZsource != 0){
    return;
  }
  float reachedDistance = max(0.0f, brakeStartDistance - max(finalDistance, 0.0f));
  float overshoot = max(0.0f, -finalDistance);
  float undershoot = max(0.0f, finalDistance);
  float settleMargin = GetStopToleranceDeg() + 0.5;
  float aggression = GetPwmTuneAggressionFactor();
  float overshootGain = 2.2f + aggression * 1.1f;
  float undershootGain = 0.45f + aggression * 0.30f;
  float recommendedWindow = reachedDistance + overshoot * overshootGain - undershoot * undershootGain + settleMargin;
  recommendedWindow = ClampFloat(recommendedWindow, 3.0, 60.0);
  float windowError = abs(recommendedWindow - PwmSlowWindowDeg);
  float normalizedError = ClampFloat(windowError / 14.0f, 0.0, 1.0);
  float overshootFactor = ClampFloat(overshoot / 8.0f, 0.0, 1.0);
  float residualFactor = ClampFloat(abs(finalDistance) / 3.0f, 0.0, 1.0);
  float adaptiveBlend = 0.16f + aggression * 0.10f + normalizedError * (0.12f + aggression * 0.05f) + normalizedError * normalizedError * 0.18f + residualFactor * (0.07f + aggression * 0.04f) + overshootFactor * (0.10f + aggression * 0.06f);
  adaptiveBlend = ClampFloat(adaptiveBlend, 0.18f, 0.82f);
  PwmSlowWindowDeg = ClampFloat(PwmSlowWindowDeg * (1.0f - adaptiveBlend) + recommendedWindow * adaptiveBlend, 3.0, 60.0);
  PersistAutoSlowWindowIfNeeded();
}

void RequestStopRamp(bool suppressBrakeLearning){
  if(IsManualStatusValue(Status)){
    RequestManualStopRamp();
    return;
  }
  if(Status<0){
    if(suppressBrakeLearning){
      SkipBrakeLearningOnManualStop = true;
    }
    Status=-3;
  }else if(Status>0){
    if(suppressBrakeLearning){
      SkipBrakeLearningOnManualStop = true;
    }
    Status=3;
  }
}

bool IsManualStatusValue(int statusValue){
  return statusValue == -23 || statusValue == -22 || statusValue == -21 || statusValue == 21 || statusValue == 22 || statusValue == 23;
}

bool IsManualPwmKeyControlEnabled(){
  return AZsource == 0 && PWMenable == true && ACmotor == false;
}

void RequestManualStopRamp(){
  if(Status == -21 || Status == -22 || Status == -23){
    Status = -23;
  }else if(Status == 21 || Status == 22 || Status == 23){
    Status = 23;
  }
}

bool IsPulseAzimuthSource(){
  return AZsource == 1;
}

unsigned int ClampPulseAzimuthTenths(int valueTenths){
  if(valueTenths < 0){
    return 0;
  }
  int maxTenths = int(MaxRotateDegree) * 10;
  if(valueTenths > maxTenths){
    return (unsigned int)maxTenths;
  }
  return (unsigned int)valueTenths;
}

long ClampPulseCount(long pulseCount){
  long maxCount = long(MaxRotateDegree) * long(max(PulsePerDegree, short(1)));
  if(pulseCount < 0){
    return 0;
  }
  if(pulseCount > maxCount){
    return maxCount;
  }
  return pulseCount;
}

void ConfigureSinglePulseCounter(pcnt_unit_t unit, int gpioPin){
  pcnt_config_t pulseCounterConfig = {};
  pulseCounterConfig.pulse_gpio_num = gpioPin;
  pulseCounterConfig.ctrl_gpio_num = PCNT_PIN_NOT_USED;
  pulseCounterConfig.lctrl_mode = PCNT_MODE_KEEP;
  pulseCounterConfig.hctrl_mode = PCNT_MODE_KEEP;
  pulseCounterConfig.pos_mode = PCNT_COUNT_INC;
  pulseCounterConfig.neg_mode = PCNT_COUNT_DIS;
  pulseCounterConfig.counter_h_lim = 32767;
  pulseCounterConfig.counter_l_lim = 0;
  pulseCounterConfig.unit = unit;
  pulseCounterConfig.channel = PCNT_CHANNEL_0;
  pcnt_unit_config(&pulseCounterConfig);
  pcnt_set_filter_value(unit, 1000);
  pcnt_filter_enable(unit);
  pcnt_counter_pause(unit);
  pcnt_counter_clear(unit);
}

void ConfigurePulseCounter(){
  ConfigureSinglePulseCounter(CwPulseCounterUnit, CwInputPin);
  ConfigureSinglePulseCounter(CcwPulseCounterUnit, CcwInputPin);
  PulseCounterConfigured = true;
}

void ApplyAzimuthSourceMode(bool useStoredPulseAzimuth){
  if(PulseCounterConfigured == false){
    return;
  }

  pcnt_counter_pause(CwPulseCounterUnit);
  pcnt_counter_pause(CcwPulseCounterUnit);
  pcnt_counter_clear(CwPulseCounterUnit);
  pcnt_counter_clear(CcwPulseCounterUnit);

  if(IsPulseAzimuthSource()){
    float seedAzimuthDeg = float(Azimuth);
    if(useStoredPulseAzimuth){
      seedAzimuthDeg = float(PulseAzimuthTenths) / 10.0f;
    }
    seedAzimuthDeg = ClampFloat(seedAzimuthDeg, 0.0f, float(MaxRotateDegree));
    PulseCounterValue = ClampPulseCount(lroundf(seedAzimuthDeg * float(max(PulsePerDegree, short(1)))));
    AzimuthRawDeg = seedAzimuthDeg;
    AzimuthControlDeg = seedAzimuthDeg;
    AzimuthNoiseDeg = 0.2f;
    Azimuth = int(round(seedAzimuthDeg));
    pcnt_counter_resume(CwPulseCounterUnit);
    pcnt_counter_resume(CcwPulseCounterUnit);
  }
}

void UpdatePulseAzimuthFromCounter(){
  if(PulseCounterConfigured == false || PulsePerDegree < 1){
    return;
  }

  int16_t cwDelta = 0;
  int16_t ccwDelta = 0;
  pcnt_get_counter_value(CwPulseCounterUnit, &cwDelta);
  pcnt_get_counter_value(CcwPulseCounterUnit, &ccwDelta);
  pcnt_counter_clear(CwPulseCounterUnit);
  pcnt_counter_clear(CcwPulseCounterUnit);

  long signedPulseDelta = long(cwDelta) - long(ccwDelta);
  if(ReverseAZ){
    signedPulseDelta = -signedPulseDelta;
  }
  if(signedPulseDelta != 0){
    PulseCounterValue = ClampPulseCount(PulseCounterValue + signedPulseDelta);
  }

  float pulseAzimuthDeg = float(PulseCounterValue) / float(PulsePerDegree);
  pulseAzimuthDeg = ClampFloat(pulseAzimuthDeg, 0.0f, float(MaxRotateDegree));
  AzimuthRawDeg = pulseAzimuthDeg;
  AzimuthControlDeg = pulseAzimuthDeg;
  AzimuthNoiseDeg = 0.2f;
  Azimuth = int(round(pulseAzimuthDeg));
}

void PersistPulseAzimuthIfNeeded(bool forceSave){
  static unsigned int lastSavedPulseAzimuthTenths = 65535;
  static long lastPulseAzimuthSave = 0;

  if(IsPulseAzimuthSource() == false){
    return;
  }

  unsigned int currentTenths = ClampPulseAzimuthTenths(int(round(AzimuthRawDeg * 10.0f)));
  if(lastSavedPulseAzimuthTenths == 65535){
    lastSavedPulseAzimuthTenths = EEPROM.readUShort(420);
  }

  bool changed = currentTenths != lastSavedPulseAzimuthTenths;
  bool enoughTimeElapsed = millis() - lastPulseAzimuthSave > 60000;
  if(changed && (forceSave || (Status == 0 && enoughTimeElapsed))){
    EEPROM.writeUShort(420, currentTenths);
    EEPROM.commit();
    lastSavedPulseAzimuthTenths = currentTenths;
    PulseAzimuthTenths = currentTenths;
    lastPulseAzimuthSave = millis();
    MqttPubString("PulseAzimuth", String(float(currentTenths) / 10.0f, 1), true);
  }
}

int GetPulseVirtualAdcValue(){
  if(IsPulseAzimuthSource() == false || MaxRotateDegree == 0){
    return int(AzimuthValue);
  }
  return int(lroundf(142.0f + (3013.0f * ClampFloat(AzimuthRawDeg, 0.0f, float(MaxRotateDegree)) / float(MaxRotateDegree))));
}

int GetPulseCounterValue(){
  return int(PulseCounterValue);
}

void PersistAutoSlowWindowIfNeeded(){
  static unsigned int LastSavedTenths = 0;
  unsigned int currentTenths = (unsigned int)round(PwmSlowWindowDeg * 10.0);
  if(LastSavedTenths == 0){
    LastSavedTenths = EEPROM.readUShort(328);
  }
  if(currentTenths != LastSavedTenths && millis()-PwmTuneSaveTimer > 60000){
    EEPROM.writeUShort(328, currentTenths);
    EEPROM.commit();
    LastSavedTenths = currentTenths;
    PwmTuneSaveTimer = millis();
    MqttPubString("PwmSlowWindowDeg", String(PwmSlowWindowDeg, 1), true);
  }
}
//-------------------------------------------------------------------------------------------------------

bool HandleManualPwmStatus(long &PwmTimer){
  if(IsManualPwmKeyControlEnabled() == false || IsManualStatusValue(Status) == false){
    return false;
  }

  switch (Status) {
    case -21: {
      ErrorDetect=0;
      ReverseProcedure(true);
      RunTimer();
      AzimuthTarget=-1;
      UiTargetAzimuth=-1;
      Status=-22;
      PwmTimer=millis();
      return true;
    }
    case -22: {
      ErrorDetect=0;
      ApplyDutySlew(PwmMaxDuty, PwmTimer);
      return true;
    }
    case -23: {
      ApplyDutySlew(0, PwmTimer);
      if(dutyCycle==0){
        ledcWrite(mosfetPWMChannel, 0);
        digitalWrite(BrakePin, LOW);
        delay(24);
        digitalWrite(ReversePin, LOW);
        Status=0;
        AzimuthTarget=-1;
        UiTargetAzimuth=-1;
        AzimuthControlDeg=AzimuthRawDeg;
      }
      return true;
    }
    case 21: {
      ErrorDetect=0;
      ReverseProcedure(false);
      RunTimer();
      AzimuthTarget=-1;
      UiTargetAzimuth=-1;
      Status=22;
      PwmTimer=millis();
      return true;
    }
    case 22: {
      ErrorDetect=0;
      ApplyDutySlew(PwmMaxDuty, PwmTimer);
      return true;
    }
    case 23: {
      ApplyDutySlew(0, PwmTimer);
      if(dutyCycle==0){
        ledcWrite(mosfetPWMChannel, 0);
        digitalWrite(BrakePin, LOW);
        delay(24);
        digitalWrite(ReversePin, LOW);
        Status=0;
        AzimuthTarget=-1;
        UiTargetAzimuth=-1;
        AzimuthControlDeg=AzimuthRawDeg;
      }
      return true;
    }
  }

  return false;
}

//-------------------------------------------------------------------------------------------------------

void RunByStatus(){
  static long PwmTimer = 0;
  static bool OneTimeSend = false;
  static bool BrakeLearningActive = false;
  static int BrakeLearningDirection = 0;
  static float BrakeStartDistance = 0.0;
  DetectEndstopZone();
  EthTest();

  if(HandleManualPwmStatus(PwmTimer)){
    return;
  }

  // }else if( (Azimuth>=0 && Azimuth<=450) ){
    switch (Status) {
      case -3: {
        if(ACmotor==false){
          //DC
          if(PWMenable==true){
            ApplyDutySlew(0, PwmTimer);
            if(dutyCycle==0){
              ledcWrite(mosfetPWMChannel, 0);
              digitalWrite(BrakePin, LOW);
              delay(24);
              digitalWrite(ReversePin, LOW);
              Status=0;
              if(BrakeLearningActive){
                if(!SkipBrakeLearningOnManualStop){
                  UpdateAutoSlowWindow(BrakeStartDistance, ReadRemainingDistanceDeg(BrakeLearningDirection, ReadRawAzimuthDeg()));
                }
                BrakeLearningActive = false;
              }
              SkipBrakeLearningOnManualStop = false;
              AzimuthTarget=-1;
              UiTargetAzimuth=-1;
              AzimuthControlDeg=AzimuthRawDeg;
            }
          }else{
            dutyCycle=0;
            ledcWrite(mosfetPWMChannel, 0);
            digitalWrite(BrakePin, LOW);
            delay(24);
            // ReverseProcedure(false);
            digitalWrite(ReversePin, LOW);
            // digitalWrite(ACcwPin, LOW);
            Status=0;
            BrakeLearningActive = false;
            SkipBrakeLearningOnManualStop = false;
            AzimuthTarget=-1;
            UiTargetAzimuth=-1;
          }
        }else{
          //AC
          digitalWrite(ACcwPin, LOW);
          digitalWrite(ReversePin, LOW);
          delay(24);
          digitalWrite(BrakePin, LOW);
          Status=0;
          BrakeLearningActive = false;
          SkipBrakeLearningOnManualStop = false;
        }
        ; break; }
      case -2: {
        if(PWMenable==true){
          MaybeBeginBrakeLearning(-1, BrakeLearningActive, BrakeLearningDirection, BrakeStartDistance);
          if(TargetReachedInDirection(-1)){
            Status=-3;
          }else if(ShouldForceStopFromPwmStall(-1, dutyCycle, ReadRawAzimuthDeg(), PwmMaxDuty)){
            Status=-3;
            MqttPubString("Debug", "Forced stop after low PWM stall during CCW braking", false);
          }else{
            ApplyDutySlew(ComputeClosedLoopDuty(-1), PwmTimer);
          }
        }else{
          if(abs(AzimuthTarget-Azimuth)<2){
            // MqttPubString("Debug", "RunByStatus-2offPWM|"+String(AzimuthTarget)+"-"+String(Azimuth)+"("+String(abs(AzimuthTarget-Azimuth))+")<2", false);
            Status=-3;
          }
        }
        ; break; }
      case -11: {
        ErrorDetect=0;
        // ReverseProcedure(true);
        if(ACmotor==false){
          //DC
          if(PWMenable==true){
            byte targetDuty = ComputeClosedLoopDuty(-1);
            if(targetDuty==0 || TargetReachedInDirection(-1)){
              Status=-3;
            }else{
              ApplyDutySlew(targetDuty, PwmTimer);
              if(dutyCycle>=targetDuty){
                Status=-2;
              }
            }
          }else{
            ledcWrite(mosfetPWMChannel, 255);
            // digitalWrite(ACcwPin, HIGH);
            Status=-2;
          }
        }else{
          //AC
          ledcWrite(mosfetPWMChannel, 0);
          if(Reverse==false){ // CCW
            digitalWrite(ACcwPin, LOW);
            digitalWrite(ReversePin, HIGH);
          }else{ // CW
            digitalWrite(ACcwPin, HIGH);
            digitalWrite(ReversePin, LOW);
          }
          Status=-2;
        }
        ; break; }
      case -1: {
        ReverseProcedure(true);
        RunTimer();
        BrakeLearningActive = false;
        SkipBrakeLearningOnManualStop = false;
        ShouldForceStopFromPwmStall(0, PwmMaxDuty, ReadRawAzimuthDeg(), PwmMaxDuty);
        Status=-11;
        OneTimeSend = false;
        PwmTimer=millis();
        ; break; }
      case  0: {
        BrakeLearningActive = false;
        SkipBrakeLearningOnManualStop = false;
        LedStatusErr();
        if(OneTimeSend==false){
          MqttPubString("AzimuthStop", String(Azimuth), false);
          OneTimeSend = true;
          TxMqttAzimuthTimer=millis();
        }
        ; break; }
      case 1: {
        ReverseProcedure(false);
        RunTimer();
        BrakeLearningActive = false;
        SkipBrakeLearningOnManualStop = false;
        ShouldForceStopFromPwmStall(0, PwmMaxDuty, ReadRawAzimuthDeg(), PwmMaxDuty);
        Status=11;
        OneTimeSend = false;
        PwmTimer=millis();
        ; break; }
      case  11: {
        ErrorDetect=0;
        // ReverseProcedure(false);
        if(ACmotor==false){
          //DC
          if(PWMenable==true){
            byte targetDuty = ComputeClosedLoopDuty(1);
            if(targetDuty==0 || TargetReachedInDirection(1)){
              Status=3;
            }else{
              ApplyDutySlew(targetDuty, PwmTimer);
              if(dutyCycle>=targetDuty){
                Status=2;
              }
            }
          }else{
            ledcWrite(mosfetPWMChannel, 255);
            // digitalWrite(ACcwPin, HIGH);
            Status=2;
          }
        }else{
          //AC
          ledcWrite(mosfetPWMChannel, 0);
          if(Reverse==false){ // CW
            digitalWrite(ACcwPin, HIGH);
            digitalWrite(ReversePin, LOW);
          }else{ // CCW
            digitalWrite(ACcwPin, LOW);
            digitalWrite(ReversePin, HIGH);
          }
          Status=2;
        }
        ; break; }
      case  2: {
        if(PWMenable==true){
          MaybeBeginBrakeLearning(1, BrakeLearningActive, BrakeLearningDirection, BrakeStartDistance);
          if(TargetReachedInDirection(1)){
            Status=3;
          }else if(ShouldForceStopFromPwmStall(1, dutyCycle, ReadRawAzimuthDeg(), PwmMaxDuty)){
            Status=3;
            MqttPubString("Debug", "Forced stop after low PWM stall during CW braking", false);
          }else{
            ApplyDutySlew(ComputeClosedLoopDuty(1), PwmTimer);
          }
        }else{
          if(abs(AzimuthTarget-Azimuth)<2){
            // MqttPubString("Debug", "RunByStatus2offPWM|"+String(AzimuthTarget)+"-"+String(Azimuth)+"("+String(abs(AzimuthTarget-Azimuth))+")<2", false);
            Status=3;
          }
        }
        ; break; }
      case  3: {
        if(ACmotor==false){
          //DC
          if(PWMenable==true){
            ApplyDutySlew(0, PwmTimer);
            if(dutyCycle==0){
              ledcWrite(mosfetPWMChannel, 0);
              digitalWrite(BrakePin, LOW);
              delay(24);
              digitalWrite(ReversePin, LOW);
              Status=0;
              if(BrakeLearningActive){
                if(!SkipBrakeLearningOnManualStop){
                  UpdateAutoSlowWindow(BrakeStartDistance, ReadRemainingDistanceDeg(BrakeLearningDirection, ReadRawAzimuthDeg()));
                }
                BrakeLearningActive = false;
              }
              SkipBrakeLearningOnManualStop = false;
              AzimuthTarget=-1;
              UiTargetAzimuth=-1;
              AzimuthControlDeg=AzimuthRawDeg;
            }
          }else{
            dutyCycle=0;
            ledcWrite(mosfetPWMChannel, 0);
            digitalWrite(BrakePin, LOW);
            delay(24);
            // ReverseProcedure(false);
            digitalWrite(ReversePin, LOW);
            // digitalWrite(ACcwPin, LOW);
            Status=0;
            BrakeLearningActive = false;
            SkipBrakeLearningOnManualStop = false;
            AzimuthTarget=-1;
            UiTargetAzimuth=-1;
          }
        }else{
          //AC
          digitalWrite(ACcwPin, LOW);
          digitalWrite(ReversePin, LOW);
          delay(24);
          digitalWrite(BrakePin, LOW);
          Status=0;
          BrakeLearningActive = false;
          SkipBrakeLearningOnManualStop = false;
        }
        ; break; }
    }
  // }
}

//-------------------------------------------------------------------------------------------------------
void ReverseProcedure(bool CCW){

  if(CCW==false){ // CW
    if(ACmotor==false){
      //DC
      if(Reverse==false){
        digitalWrite(ReversePin, LOW);
      }else{
        digitalWrite(ReversePin, HIGH);
      }
      delay(24);
      digitalWrite(BrakePin, HIGH);
    }else{
      //AC
      digitalWrite(BrakePin, HIGH);
      delay(24);
    }
  }else{  // CCW
    if(ACmotor==false){
      //DC
      if(Reverse==false){
        digitalWrite(ReversePin, HIGH);
      }else{
        digitalWrite(ReversePin, LOW);
      }
      delay(24);
      digitalWrite(BrakePin, HIGH);
    }else{
      //AC
      digitalWrite(BrakePin, HIGH);
      delay(24);
    }
  }
   delay(12);
}




String LeadingZero(int NumberOfZero, int NR){
  String StrBuf = String((int)round(NR));
  if(StrBuf.length()>NumberOfZero){
    StrBuf="0";
  }
  for (int i=StrBuf.length(); i<NumberOfZero; i++){
    StrBuf="0"+StrBuf;
  }
  return StrBuf;
}

void CLI2(){
  int OUT=2;
  if (Serial.available() > 0) {
    incomingByte = Serial.read();
    OUT = 0;
  }
  esp_task_wdt_reset();
  WdtTimer=millis();


/*
https://www.yaesu.com/downloadFile.cfm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
https://www.passion-radio.com/index.php?controller=attachment&id_attachment=782
https://www.qsl.net/dh1ngp/onlinehelpft100/Rotator_control_with_Easycomm.htm
https://www.mustbeart.com/software/easycomm.txt

Command		Meaning			Perameters
-------		-------			----------
AZ		Azimuth			number - 1 decimal place
ML		Move Left
MR		Move Right
SA		Stop azimuth moving

EL		Elevation		number - 1 decimal place
UP		Uplink freq		in Hertz
DN		Downlink freq		in Hertz
DM		Downlink Mode		ascii, eg SSB, FM
UM		Uplink Mode		ascii, eg SSB, FM
DR		Downlink Radio		number
UR		Uplink Radio		number
MU		Move Up
MD		Move Down
SE		Stop elevation moving
AO		AOS
LO		LOS
OP		Set output		number
IP		Read an input		number
AN		Read analogue input	number
ST		Set time		YY:MM:DD:HH:MM:SS
VE		Request Version

GS-232B
-------
R 82 Clockwise Rotation
L 76 Counter Clockwise Rotation
A 65 CW/CCW Rotation Stop
  S 83 All Stop
C 67 Antenna Direction Value
M 77 Antenna Direction Setting. MXXX
O 79 Offset Calibration
F 70 Full Scale Calibration
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
