ok1hra/IP-rotator/(commit log)

2023-03-17 add calibrate gui
2023-03-17 add calibrate .html
2023-03-19 add software endstops
2023-03-25 add L/H endstopzone|control key|AZ pot master|LED
2023-04-04 set baudrate, warm up timer
2023-04-13 add reverse azimuth button
    [ip-rot.ino]
2023-04-21 fix preamp pin
2023-04-22 fix cw/ccw input key|tune gui|fix LED
    [ip-rot.ino]
2023-04-30 add brake to DC mode|disable mqtt if first digit zero
2023-05-06 Disable PWM from setup
2023-05-25 CN3A static IP|AC-cw with PWM disable
2023-06-03 reset save set butt|callibrate front pot
    [ip-rot.ino]
2023-06-03 fix calculate AzimuthTarget from gui and potentiometer|fix gui
    [ip-rot.ino]
2023-07-22 DC use brake relay|release 20230722
2023-07-28 fix gui, disable mosfet during AC
    [ip-rot.ino]
2023-12-08 support HW rev 06|Voltage limit to 11.5V
2024-04-20 fix POE under voltage limit and stop
    [ip-rot.ino]
2024-04-27 azimuth target pot fix
    [ip-rot.ino]
2024-10-02 - renamed file for Arduino compliance (see https://arduino.github.io/arduino-cli/latest/sketch-specification/#primary-sketch-file) - fixed bug in ARDUINO_EVENT_ETH_GOT_IP which was causing incorrect 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
    [IP-rotator.ino]
2024-10-02 fixed mqtt topic string
    [IP-rotator.ino]
2024-10-09 bugfix - TNX Joerg DL3QQ
    [IP-rotator.ino]
2024-10-12 new PWM settings in GUI
2024-11-07 fix gs-232 "C" command output
    Fix the output of the "C" command so it matches the Yaesu specification. Fixes issue with PstRotatorAz not showing rotator direction.
    [IP-rotator.ino]
2026-04-18 Add bigger map | use SPIFFS mem | some updates
    [partitions.csv]
2026-04-19 redesign PWM loop | add SPEED control
    [IP-rotator.ino]
2026-04-19 precise PWM algorytm | UI fix
    [IP-rotator.ino]
2026-04-21 first page upload button, speed to bitmap version
2026-04-21 manual tune sw endstop, find LOC, DEG ANT switch
2026-05-01 bugfix | Release 20260501
    [IP-rotator.ino]
2026-05-06 redesign UI | rev 20260506
    [IP-rotator.ino]
2026-05-22 fix TrxNet | rev 20260522
    [IP-rotator.ino]
